electrosense/hardware/converter-design-files/Template2.PcbDoc.htm

Reporting Options

# File in Previous Format

Date | : | 9/7/2021
Time | : | 11:13:33 AM
Filename | : | D:\elesensehw\hardware\converter-design-files\Template2.PcbDoc

Version | Warning

This file was generated by an earlier version of the software
