electrosense/hardware/extension_board_v2/Bill of Materials.xlsx

Name | Description | Designator | Quantity | Supplier 1 | Supplier Part Number 1
BAT1704WH6327XTSA1 |  | BAT1 | 1 | Farnell | 2725755
100nF | smd capaciteit, verp.0603, 100nF | C01, C02, C03, C06, C09, C10, C12, C13, C14, C15, C24, C28, C29, C30, C58 | 15 | Farnell | 2320813
10pF | smd capaciteit, verp.0603, 10pF | C04, C05, C66, C68 | 4 | Farnell | 1414601
10uF | smd capaciteit, tantalium, verp.1206, 10uF/10V | C07, C08 | 2 | Farnell | 2776894
10nF | smd capaciteit, verp.0603, 10nF | C11, C57, C61, C62, C63 | 5 | Farnell | 1907314
10nF | smd capaciteit, verp.0402, 10nF | C16, C17, C18, C19, C40 | 5 | Farnell | 1828887
1uF | smd capaciteit, verp.0603, 1uF | C20, C21, C22, C47 | 4 | Farnell | 1650837
12nF | smd capaciteit, verp.0603, 12nF | C23 | 1 | Farnell | 1865466
820pF | smd capaciteit, verp.0603, 820pF | C25 | 1 | Farnell | 2496915
22pF | smd capaciteit, verp.0402, 22pF | C26, C27, C31, C35, C36, C37 | 6 | Farnell | 2218849
1pF | smd capaciteit, verp.0402, 1pF | C32 | 1 | Farnell | 2781427
CSMD402/1nF | smd capaciteit, verp.0402, 1nF | C33 | 1 | Farnell | 1535558
100nF | smd capaciteit, verp.0402, 100nF | C34, C38, C41, C43, C44, C51, C70 | 6 | Farnell | 2627341
47pF | smd capaciteit, verp.0402, 47pF | C39, C67, C54, C55, C56 | 5 | Farnell | 2332508
100pF | smd capaciteit, verp.0402, 100pF | C42, C53, C45 | 3 | Farnell | 2496792
CSMD402/1.5nF | smd capaciteit, verp.0402, 1.5nF | C46 | 1 | Farnell | 2522382
47pF | smd capaciteit, verp.0603, 47pF | C59, C60, C64, C65 | 4 | Farnell | 1759062
ESD0P8RFL |  | D2, D3, D5 | 3 | Farnell | 1791462
DPX165850DT-8017A1 |  | F1 | 1 | Mouser | 810-DPX16585DT8017A1
CONSMA | SMA connector, rechtop | HIGH, LOW, MID, SDR1 | 4 | Farnell | 1248989
CON SMD USB Micro MOLEX | MOLEX - 47589-0001 - MICRO USB TYPE AB | JUSB | 1 | Digikey | WM17143CT-ND
Ferrite | Ferrite bead, 0805 package | L01, L5 | 2 | Farnell | 1669753
SPL603/51nH |  | L2 | 1 | Farnell | 2286003
SPL805/470nH | smd spoel, verpakking 805, 470nH | L3, L6, L7, L8, L9, L10 | 6 | Farnell | 2286389
HSMG-C190 | led smd groen, Avago Techn., HSMG-C190 | LOCK | 1 | Farnell | 2497374
HSMY-C190 | led smd geel, Avago Techn., HSMY-C190 | MIX | 1 | Farnell | 2497355
1K5 | weerstand SMD603, 1K5 | R01, R05 | 2 | Farnell | 2447592
750 | weerstand SMD603, 750R | R02, R03, R04 | 3 | Farnell | 2447432
51 | weerstand SMD603, 51R | R06, R07, R26, R27, R28 | 5 | Farnell | 2059275
5K1 | weerstand SMD603, 5K1 | R08 | 1 | Farnell | 1670185
270 | weerstand SMD805, 270R | R09 | 2 | Farnell | 1697424
 | weerstandsnetwerk SMD603, 4x 22R | R10 | 1 | Farnell | 2060088
50R/402 | weerstand SMD402, 50R | R12, R13, R14 | 3 | Farnell | 2447183
240 | weerstand SMD603, 240R | R15, R100 | 1 | Farnell | 2447305
 | weerstand SMD603, 30R | R16 | 1 | Farnell | 2141216
91 | weerstand SMD603, 91R | R17 | 1 | Farnell | 2303055
 | weerstand SMD805, 1K8 | R18, R19 | 2 | Farnell | 2447595
20R/402 | weerstand SMD402, 20R | R20 | 1 | Farnell | 2324285
51 | weerstand SMD402, 51R | R21, R22, R23 | 3 | Farnell | 2447183
10K | weerstand SMD603, 10K | R24, R25 | 2 | Farnell | 2447230
390 | weerstand SMD603, 390R | R36HF | 1 | Farnell | 2502455
BR39162B3522U410 | Saw Filter | SAW1 | 1 | Farnell | 2360869
BC856 | PNP transistor, smd | T2HF | 1 | Farnell | 1081242
STM32F103C8T6 |  | U1 | 1 | Farnell | 1447637
IP4220CZ6 | Dual USB 2.0 integrated ESD protection | U2 | 1 | Farnell | 1506629
LD1117-SOT223 |  | U3 | 1 | Farnell | 1467776
MAX2870 |  | U4 | 1 | Farnell | 2517417
MCP9804 | ±0.25°C Typical Accuracy Digital Temperature Sensor | U5 | 1 | Farnell | 1825061
SBB3089Z | RF Amplifier | U6 | 1 | Farnell | 2066354
SKY13286-359LF | SPDT-J2/J1 to RFC | U7 | 1 | Mouser | 873-SKY13286-359LF
LTC5549 |  | U8 | 1 | Farnell | 2506414
ADL5602 | Gain block | U9 | 1 | Farnell | 2377140
SKY13322-375LF |  | U11 | 1 | Mouser | 873-SKY13322-375LF
SA612 |  | U12 | 1 | Farnell | 2212081
HSMH-C190 | led smd rood, Avago Techn., HSMH-C190 | USB | 1 | Mouser | 630-HSMH-C190
KTL/5x3.2mm16MHz | TXC Xtal 16.000 MHz, 5x3.2mm | X1 | 1 | Farnell | 2854044
7L-38.400MDG-T |  | X2 | 1 | Farnell | 2325484
MMSZ4678T1G | Zener diode 1.8V | DZ1 | 1 | Digikey | MMSZ4678T1GOSDKR-ND
