electrosense/hardware/(threads)

Thread 1 (2021-04-15):

could i use this board to connect kiwisdr?

taskx6004, 2021-04-15:
Hi, I need a simple and elegant design to connect kiwisdr, I saw recent update v2 board has deleted only one RF route connected to the up converter mixer, is it capable to mix 60MHz-6Ghz in firmware? Some modification require for RF parts maybe required but I am not sure. I can help with your new board assembly (in Shenzhen).

ingframin, 2021-04-15:
Hello, the circuit is exactly the same in version 2. I simply removed a connector and few components that were not used anymore in later iterations. The redesign is actually a cost reduction rather then a functional redesign. You can for sure use this with the kiwi sdr. As for assembly I am not in a position to change our supplier.

taskx6004, 2021-04-16:
Thanks for the reply, I will try to layout a version without up converter, and look into the firmware.

ingframin, 2021-04-16:
Start from V1 though... The V2 is still work in progress and it doesn't really work yet. Also, if you build V2, mark C30 as DNP or you need to change the firmware to disable MCO and use the TCXO as reference for the PLL.

taskx6004, 2021-04-16:
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
I am porting the design in KiCAD (5.99/6), due to current shortage of ICs, some parts may need to be replaced, I will check my sch and send BOM for availability check. I hope it won't be too hard to put it on a 5x5 cm with 0.4/0.2 via 4 layer board.

If it's appropriate I hope continue using this issue for further questions and hope you can help me figure it out.

taskx6004, 2021-04-19:
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

Hi, I spend some time to re-layout the v1 design by using KiCAD. And here are some concerns about my layout:

- the TCXO output to MCU and the LO Line to up converter part will inevitably cross, i have to use a via jump to feed the XO clock to MCU.
- currently the MCU is more than 10USB, would it be feasible to do it on a STM32g431 or newer more available chips?
- the trace is 50 ohm controlled. but the clock branching and tracing is cornered. I don't know how this board will perform.
Any advice for me? Thank you in advance.

BertoldVdb, 2021-04-19:
You do not need to connect the TCXO to the MCU. This connection is only to use the MCU clock for the PLL REF during testing. If you use one of the newer MCU you can even use the internal oscillator as the accurate clock is only used for USB.

I think it should be quite easy to use another MCU. I find STM32 in general difficult to find at the moment.

The upconverter does not perform well, it was only added to meet a specification requirement.

Closed 2021-04-15.

Thread 2 (2021-07-19):

Can it be use on a LimeSDR (which is limited to 3.8GHz)?

OhSoGood, 2021-07-19:
Hi,
Congratulation for the project, and it's so nice to share it with everybody.

I offered myself a nice LimeSDR a few months ago (it goes up to 3.8GHz), and I was wondering if I could use your board for both RX and TX up to 6GHz? If so, with V1 or V2 of the board?

Are there any drawback you know to use such a converter? RF bandwidth limitation, I/Q balance, interference/harmonics, whatsoever ?

Thanks again

BertoldVdb, 2021-07-19:
Hi,

Yes, it will work with a LimeSDR or any other receiver that can use the
1.575GHz IF. The bandwidth with the filter mentioned in the BOM is quite
low, as it was made for the rtl-sdr. You can replace it with another GPS
SAW with a wider passband.

Sincerely,
Bertold

Op ma 19 jul. 2021 18:27 schreef OhSoGood ***@***.***>:

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

Thread 3 (2022-03-14):

Questions on your design

OhSoGood, 2022-03-14:
Hi,
The overall design of the board is great but there are a few points I don't get:

1. Why to "gather" the input from the 2.4 and 5.8GHz antennas with a RF switch, then to amplify them and next to split them with a diplexer to finally arrive to the SKY13286 RF switch ? Why not a distinct circuit for both bands, each with its own amplifier, and directly connected to the SKY13286 RF switch?
2. Why the ADL5602 amplifier at the final stage? Does the whole chain weaken the signal enough so that we need a LNA/PA at the end? And why not a stronger ampli than SBB3089Z instead of two amplis, one at the head the other at the end of the board?
3. In practice, how many dB does a 2.4 or 5.8 GHz signal loose going through the board?

Thank you very much for the feedback :)
