electrosense/hardware/converter-design-files/schematic.pdf

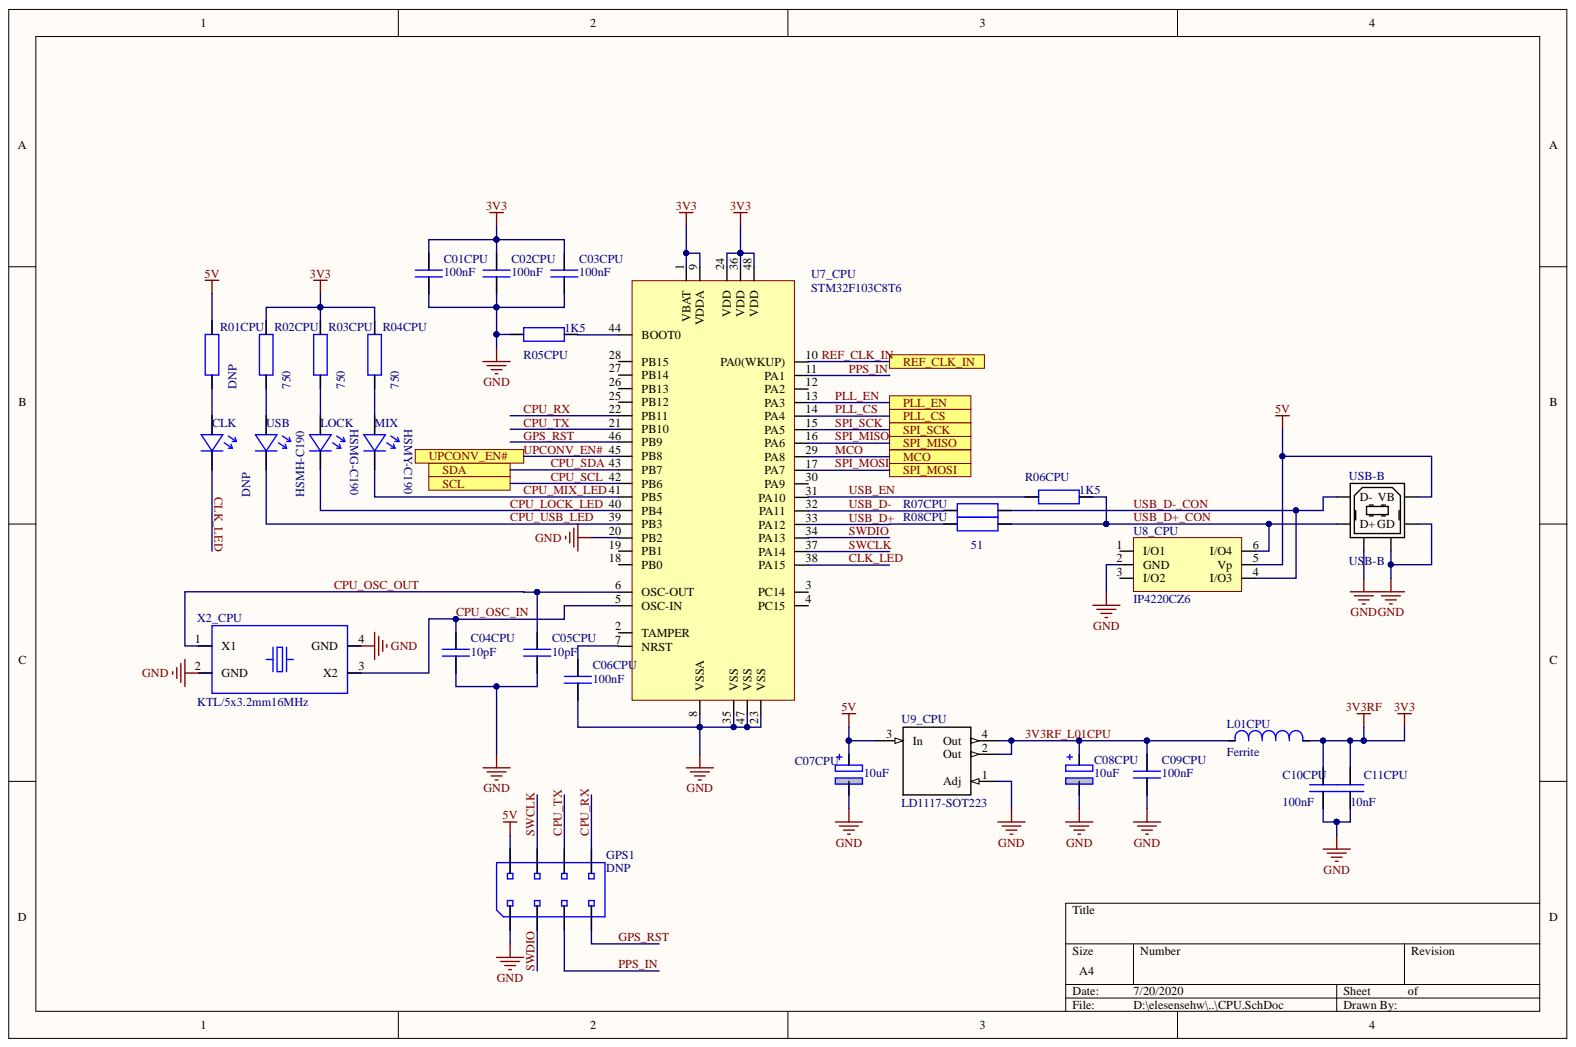
[picture p8: page 1]

PB8 45 PB9 46 | MCO | SPI_MISO

X1 1 | GND

Date: 7/20/2020 | Sheet of
File: D:\elesensehw\..\CPU.SchDoc | Drawn By:

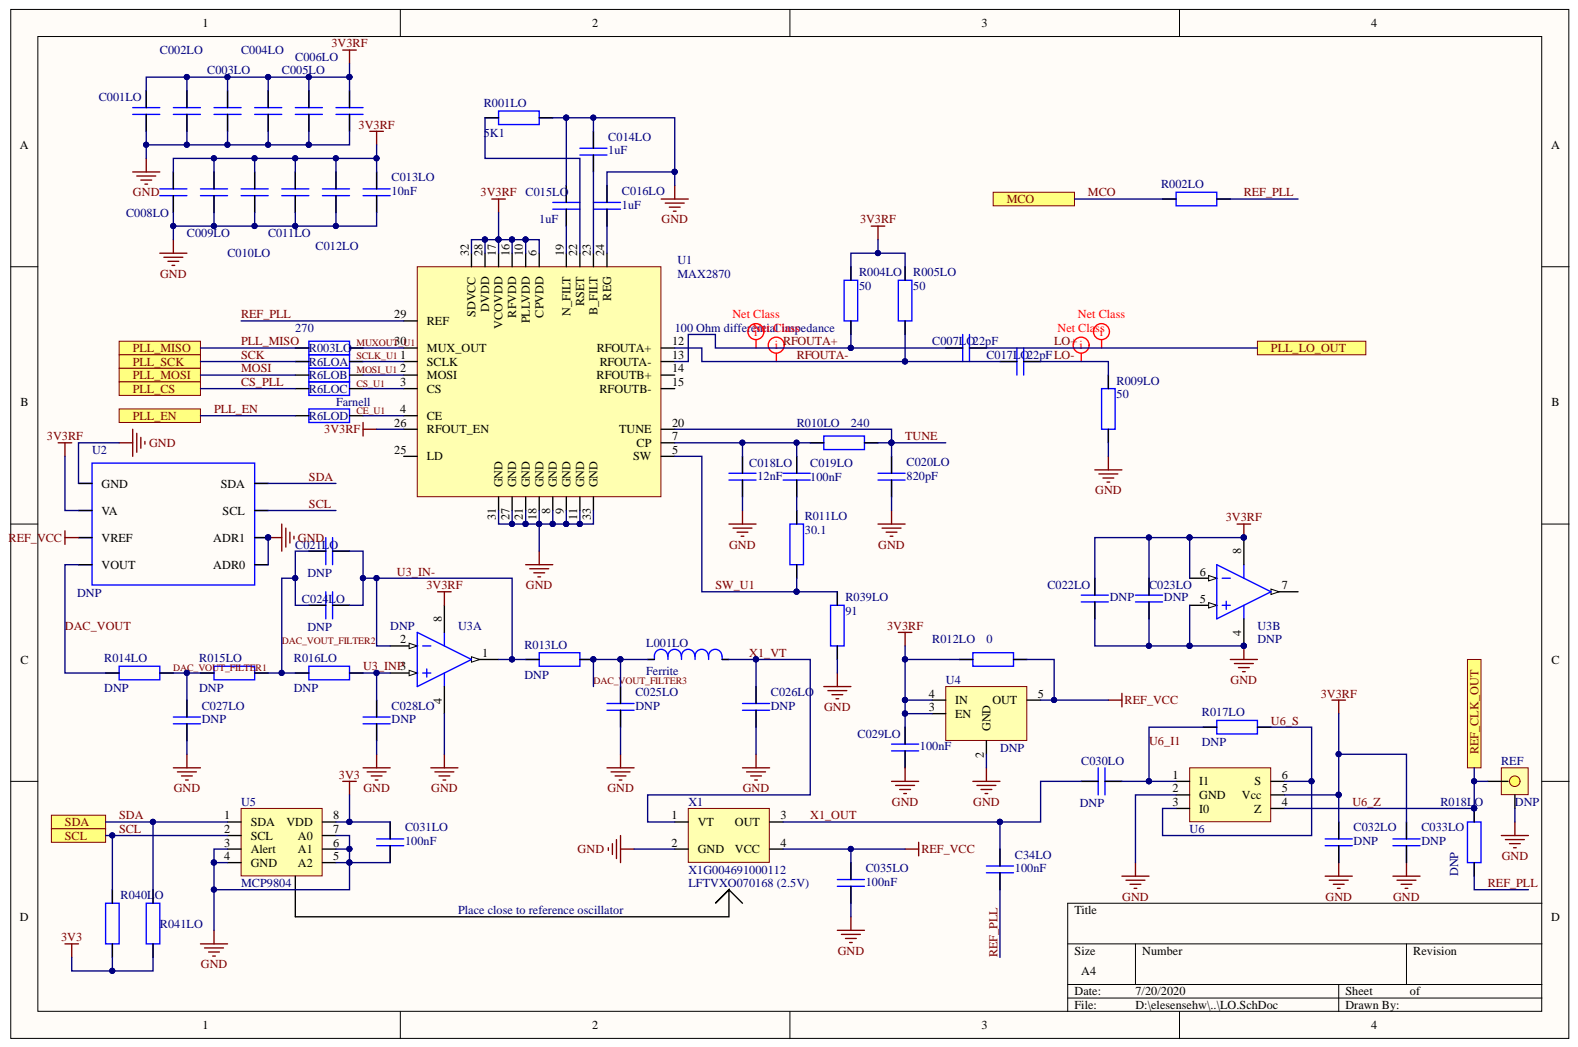
[picture p9: page 2]

SCK | SCLK_U1 | SCLK 1 | RFOUTA- | LO-
MOSI | MOSI_U1 | MOSI 2
CS_PLL | CS_U1 | CS 3

PLL_SCK | R6LOA

PLL_CS | R6LOC

Place close to reference oscillator

Size A4 | Number | Revision

Date: 7/20/2020 | Sheet of
File: D:\elesensehw\..\LO.SchDoc | Drawn By:

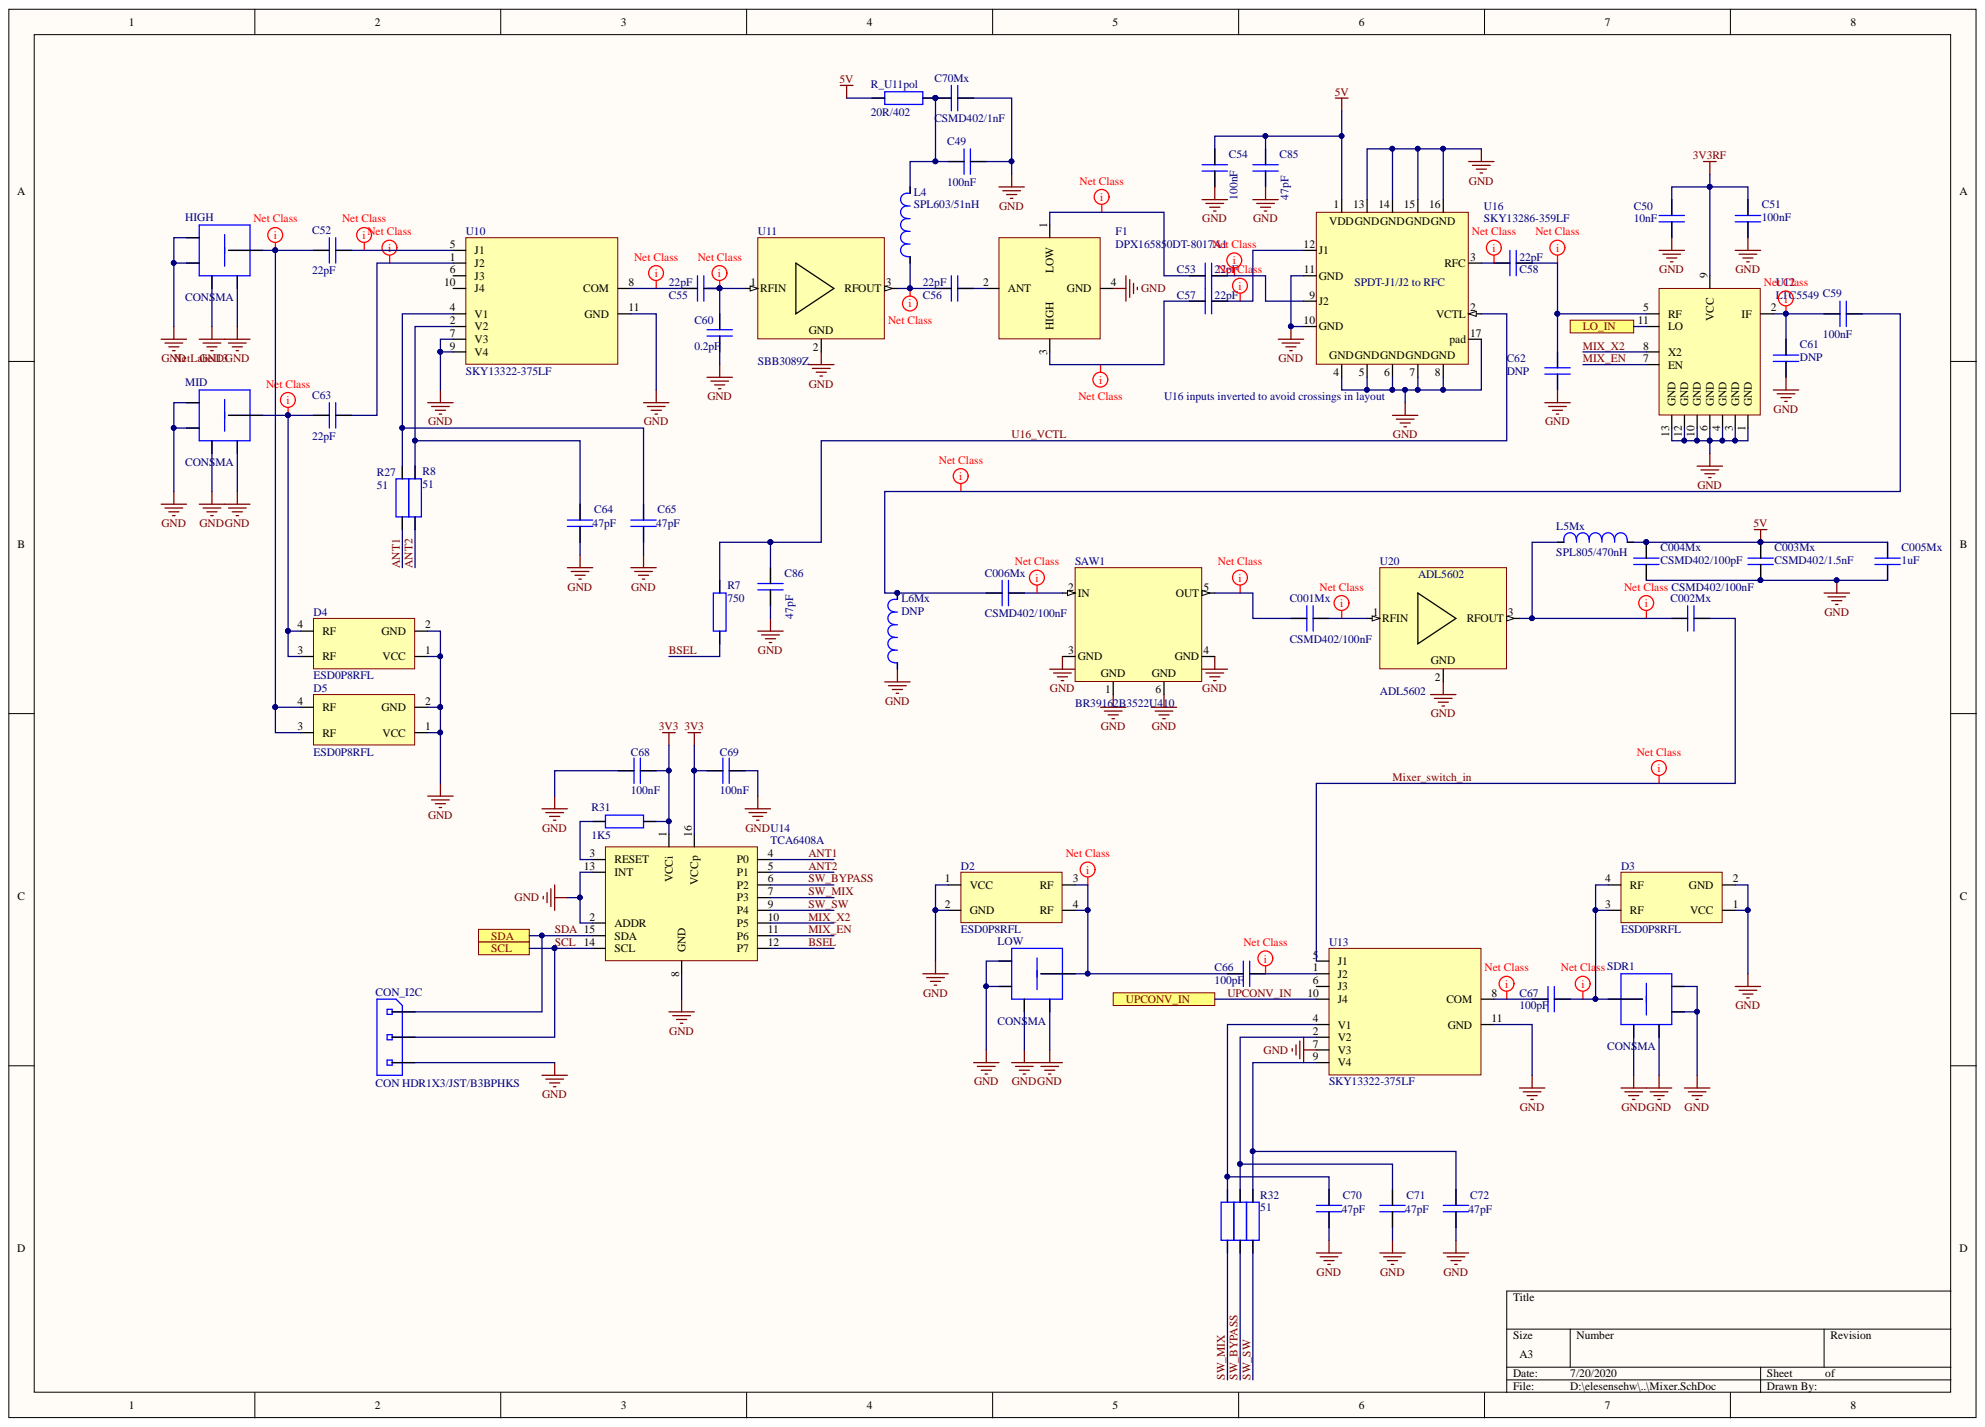
[picture p10: page 3]

U16 inputs inverted to avoid crossings in layout

GND 1 GND 3 GND 4 GND 6 GND 10 GND 12

SDA | SCL | SCL 14
SCL

J2 1 J1 5 | Net Class | SDR1

V3 7
V4 9

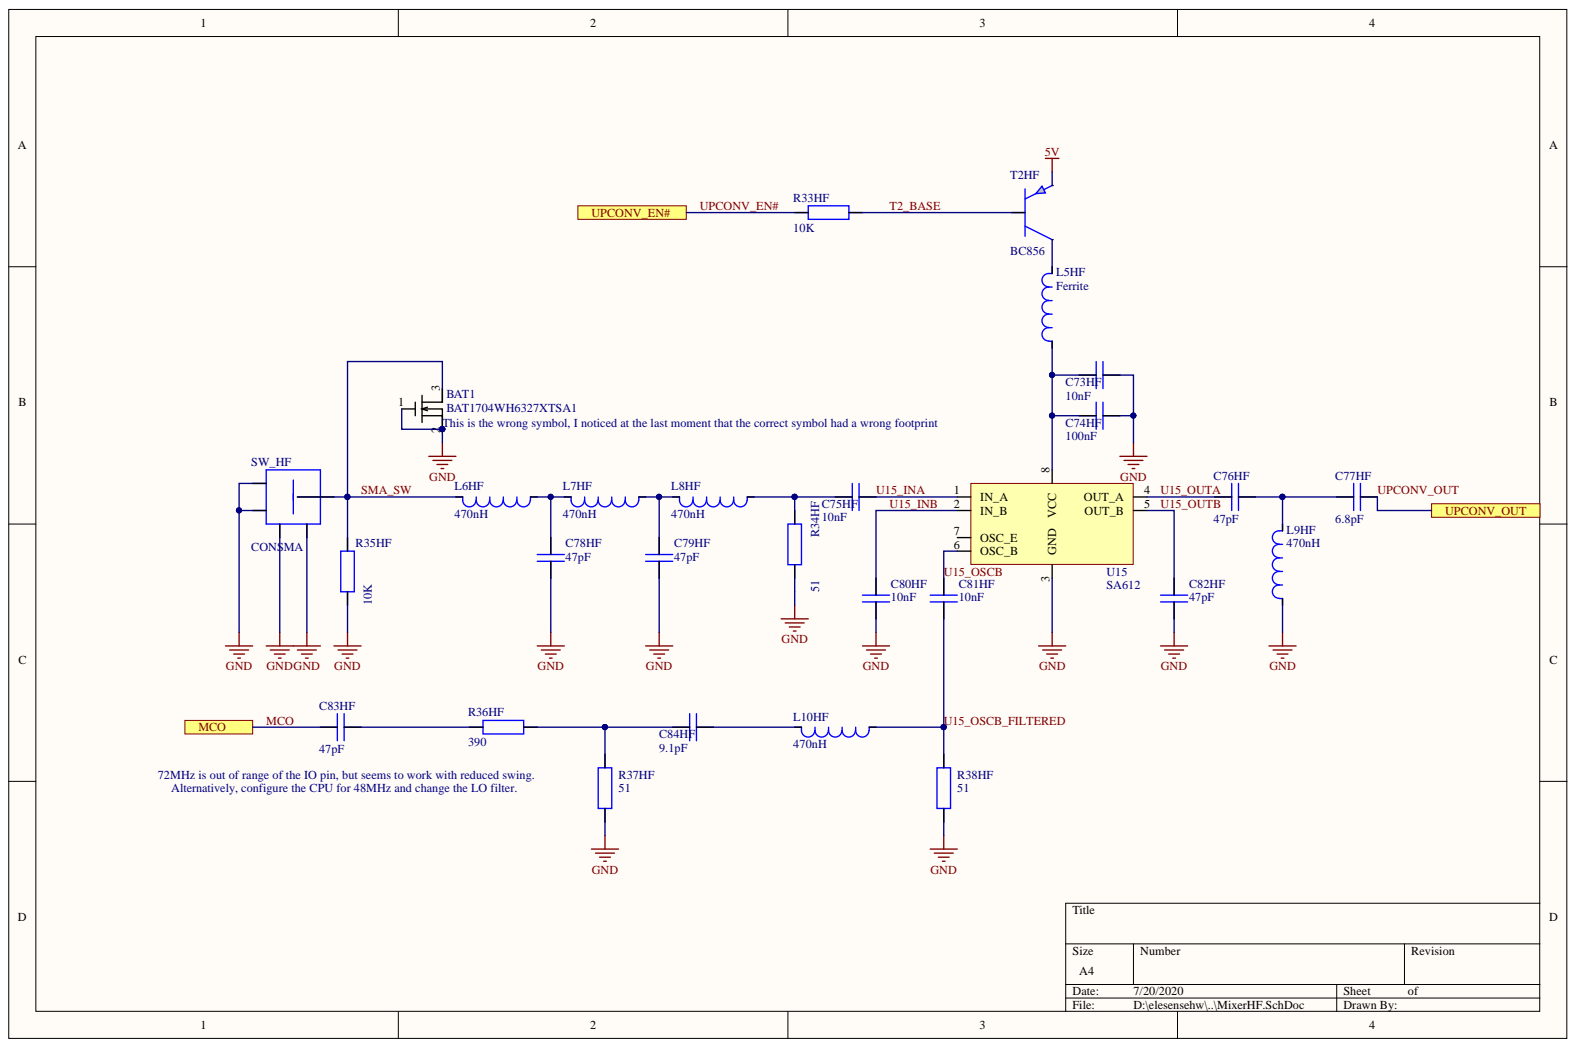
[picture p11: page 4]

3 2 BAT1
BAT1704WH6327XTSA1
This is the wrong symbol, I noticed at the last moment that the correct symbol had a wrong footprint

72MHz is out of range of the IO pin, but seems to work with reduced swing.
Alternatively, configure the CPU for 48MHz and change the LO filter.

Size A4 | Number | Revision

Date: 7/20/2020 | Sheet of
File: D:\elesensehw\..\MixerHF.SchDoc | Drawn By:

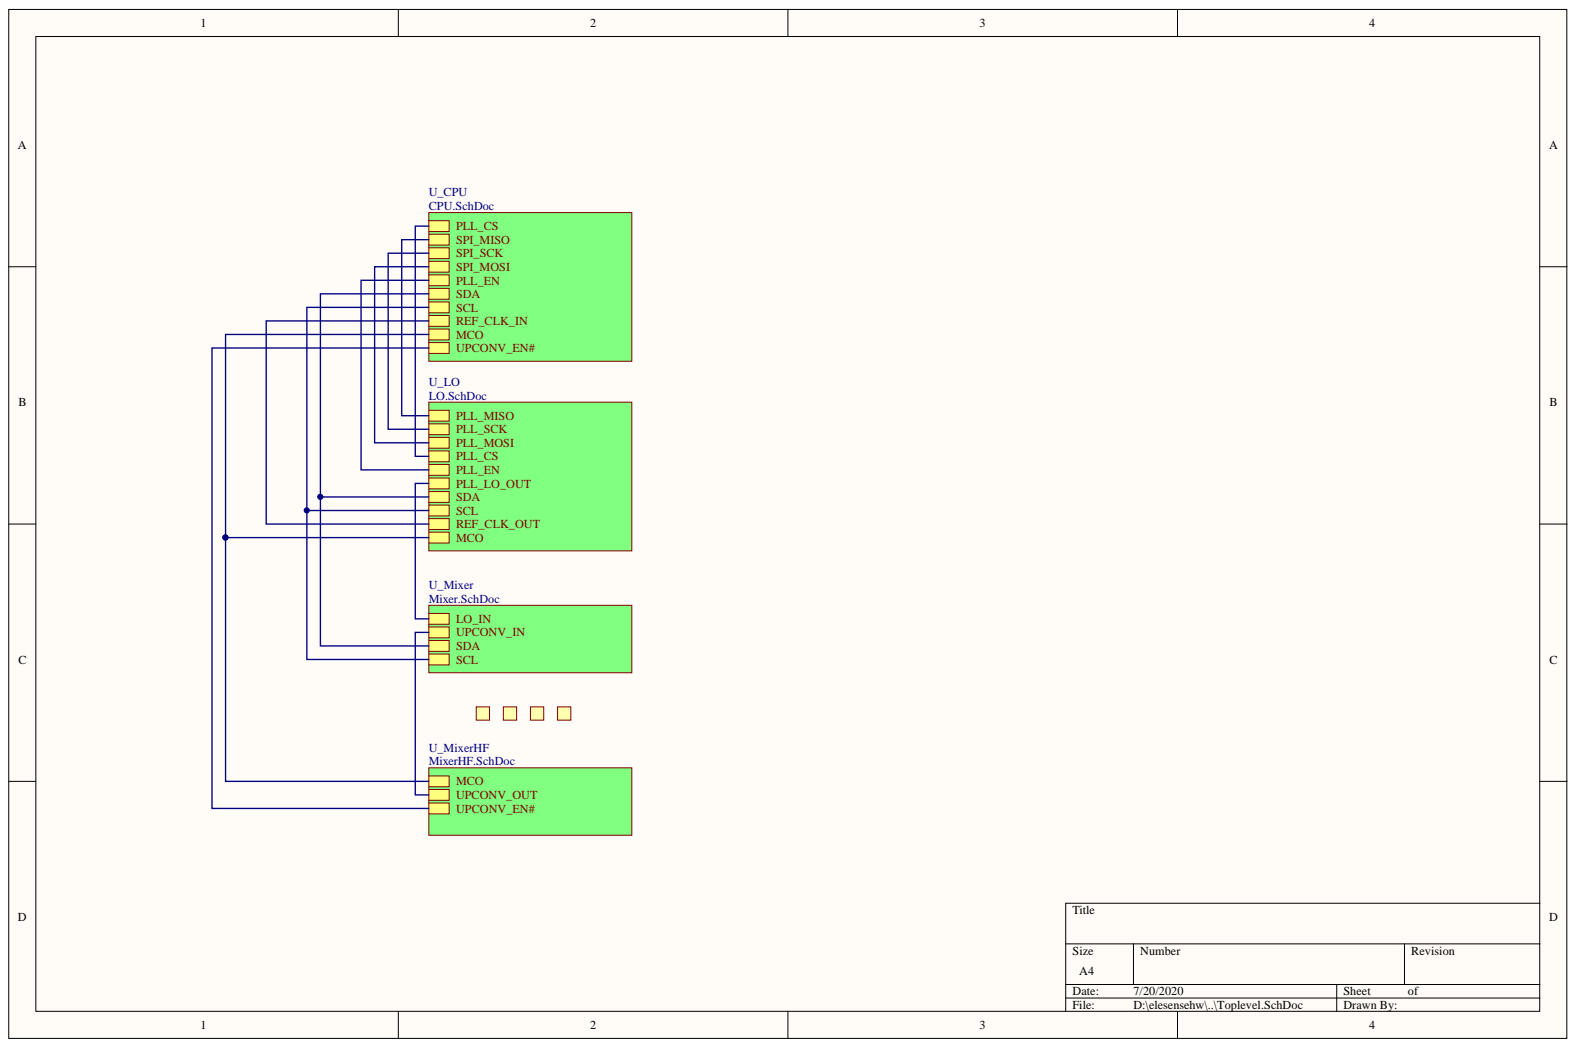
[picture p12: page 5]

Size A4 | Number | Revision

Date: 7/20/2020 | Sheet of
File: D:\elesensehw\..\Toplevel.SchDoc | Drawn By:
