electrosense/hardware/extension_board_v2/PCB_Project3.pdf

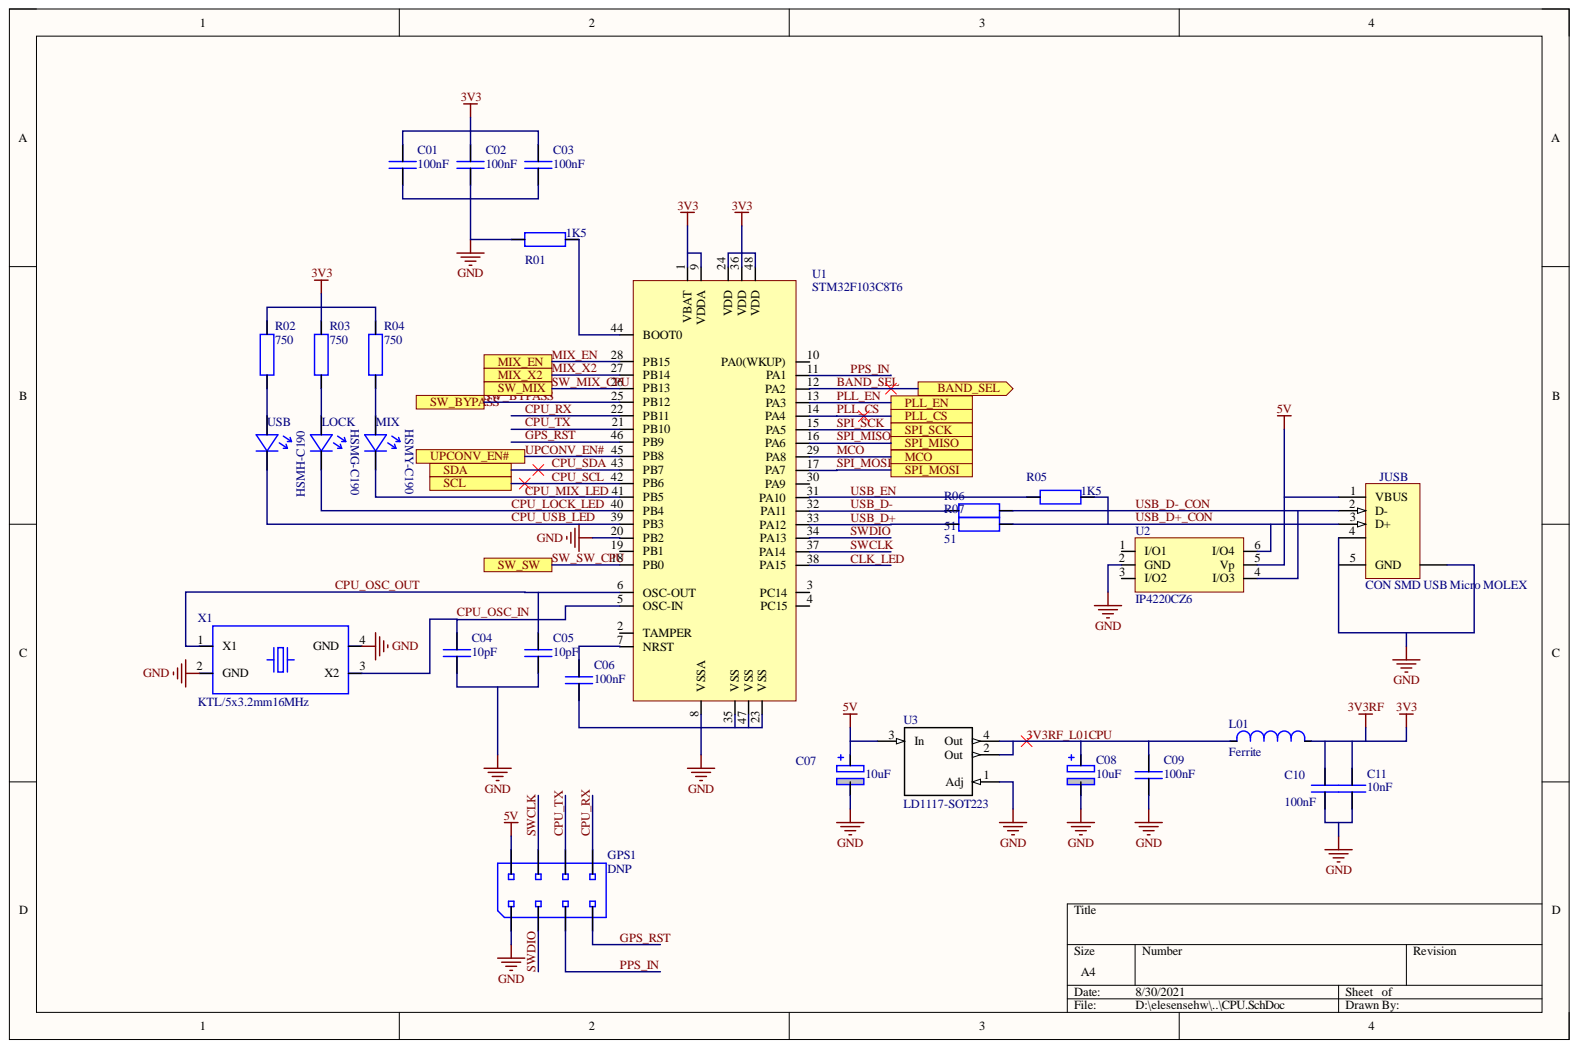
[picture p13: page 1]

CPU_SCL | PB3 39 PB4 40 PB5 41 PB6 42 PB7 43

SDA | SPI_MOSI

CON SMD USB Micro MOLEX

Date: 8/30/2021 | Sheet of
File: D:\elesensehw\..\CPU.SchDoc | Drawn By:

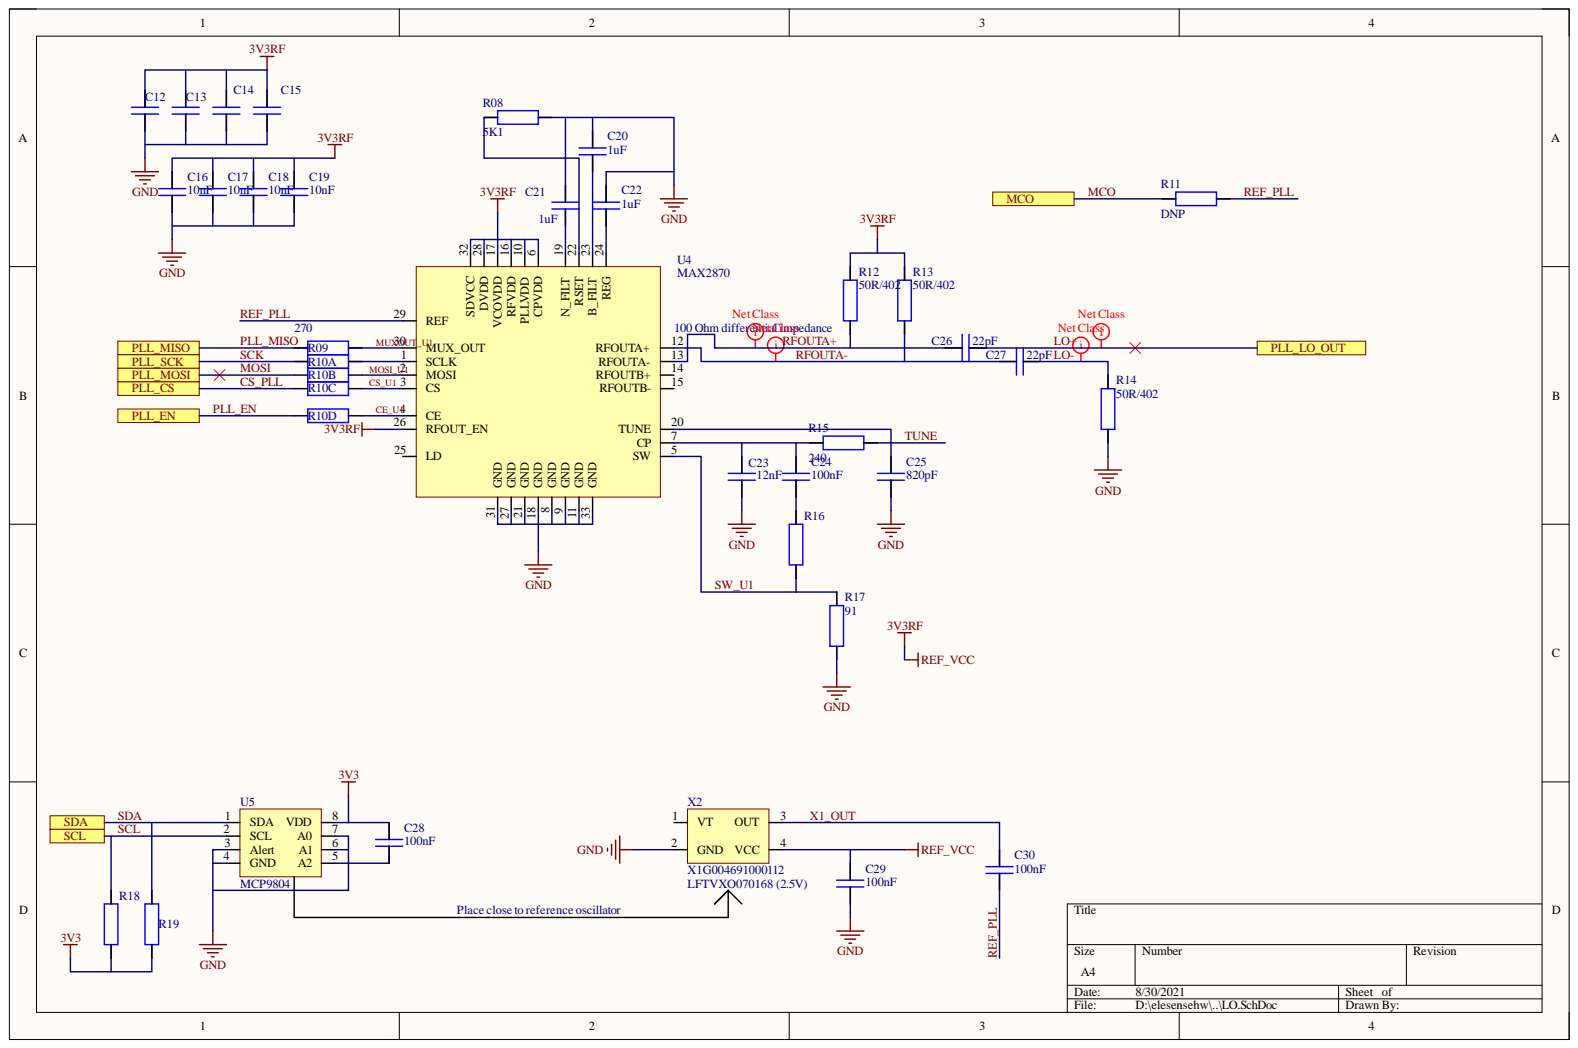
[picture p14: page 2]

SCK | | SCLK 1
MOSI | MOSI_U1 | MOSI 2
CS_PLL | CS_U1 | CS 3

PLL_SCK | R10A
PLL_MOSI | R10B
PLL_CS | R10C

Place close to reference oscillator

Size A4 | Number | Revision

Date: 8/30/2021 | Sheet of
File: D:\elesensehw\..\LO.SchDoc | Drawn By:

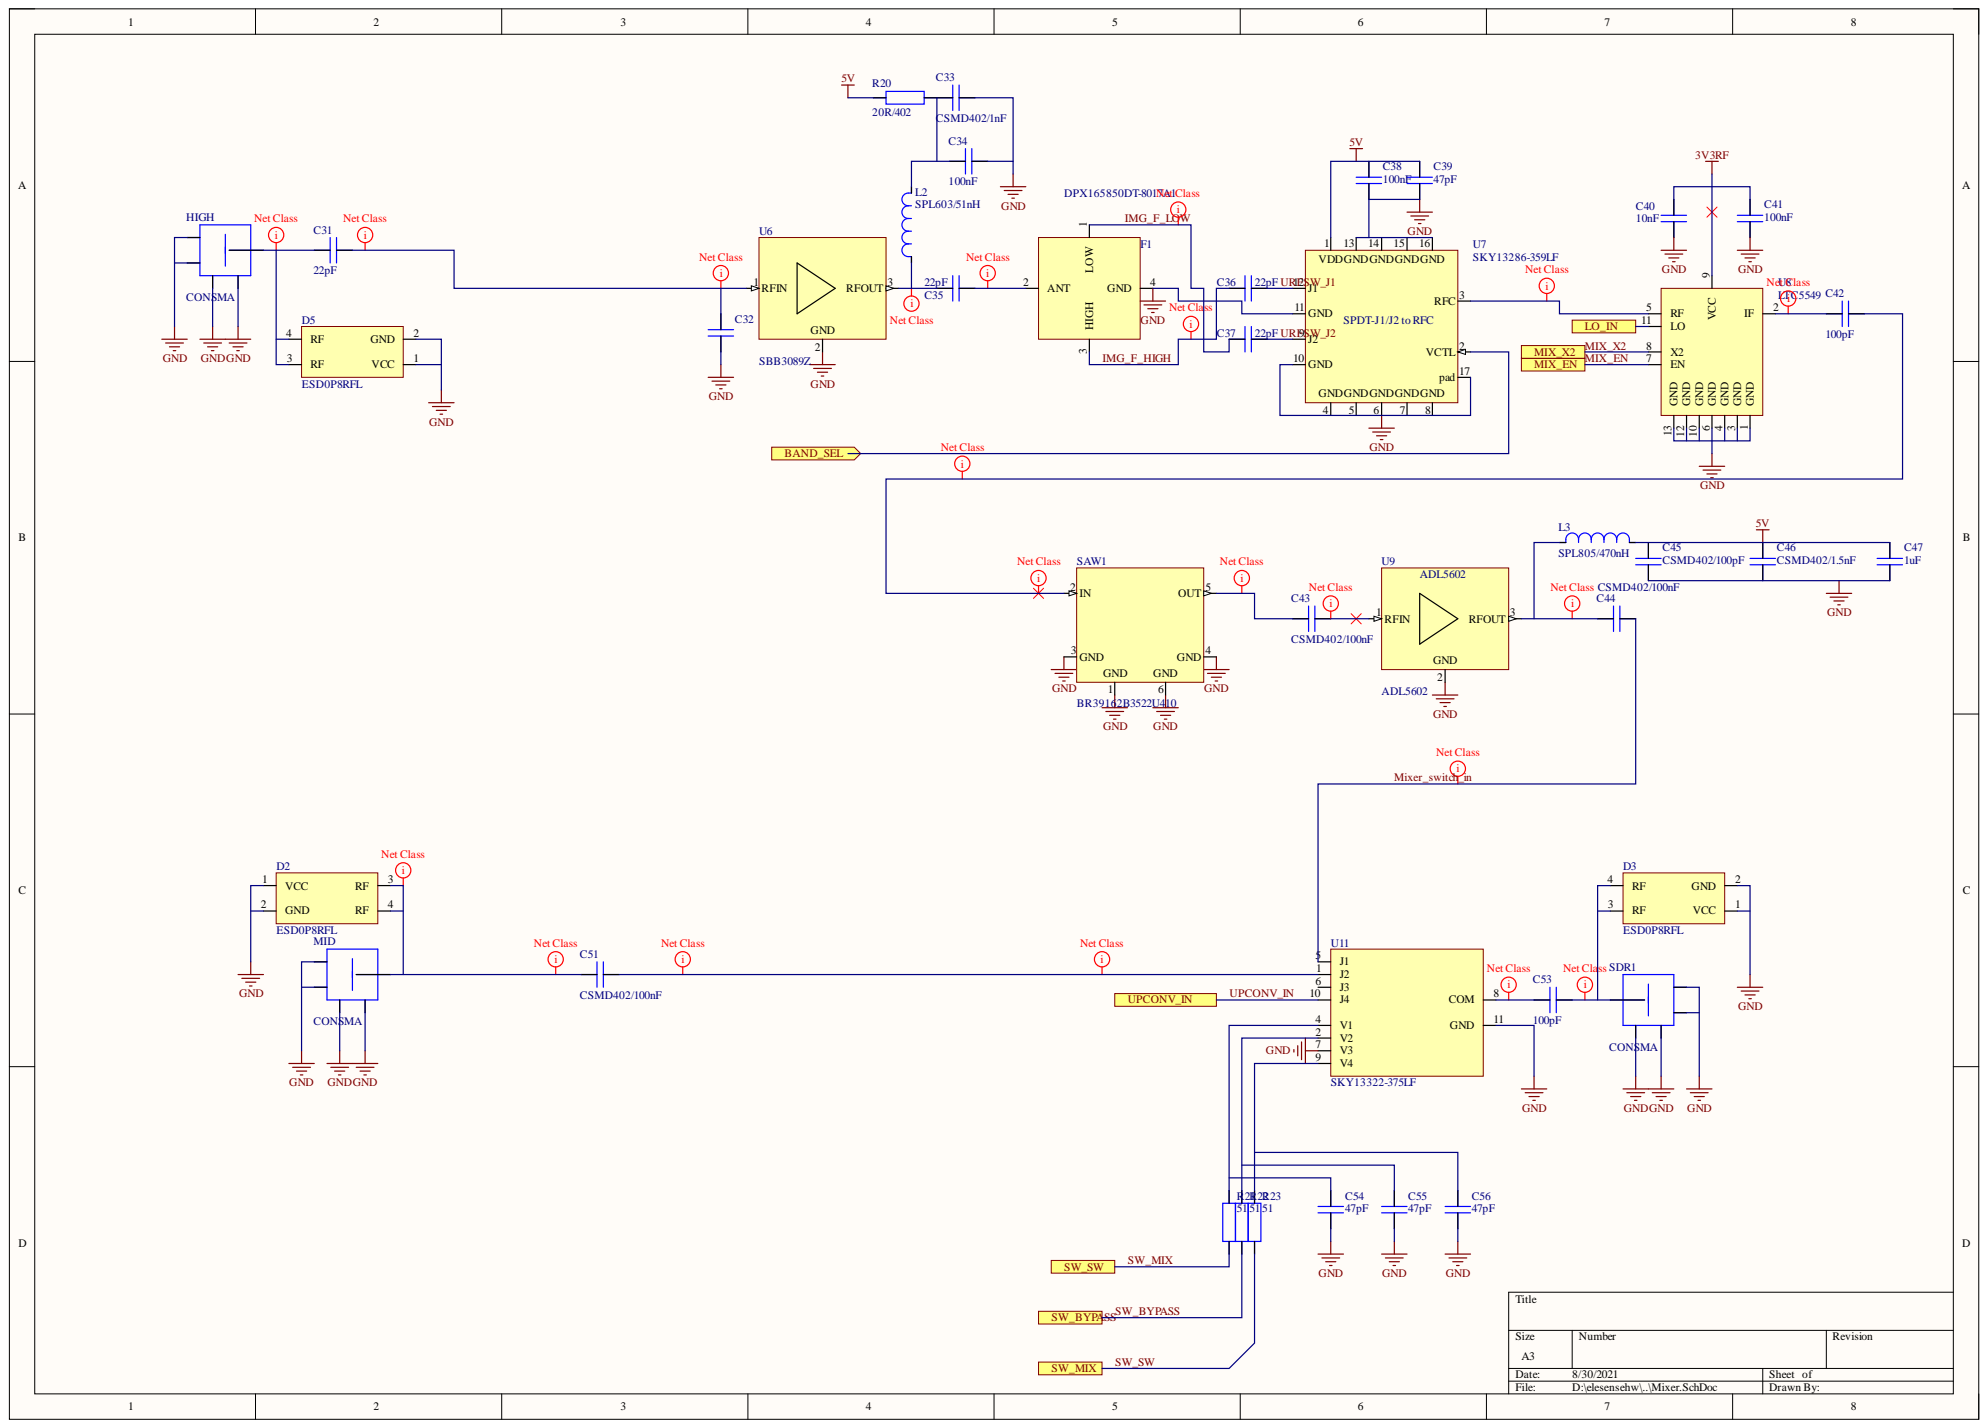
[picture p15: page 3]

GND 1 GND 3 GND 4 GND 6 GND 10 GND 12

R21 | R22
51 | 51

SW_SW | | SW_BYPASS

SW_MIX

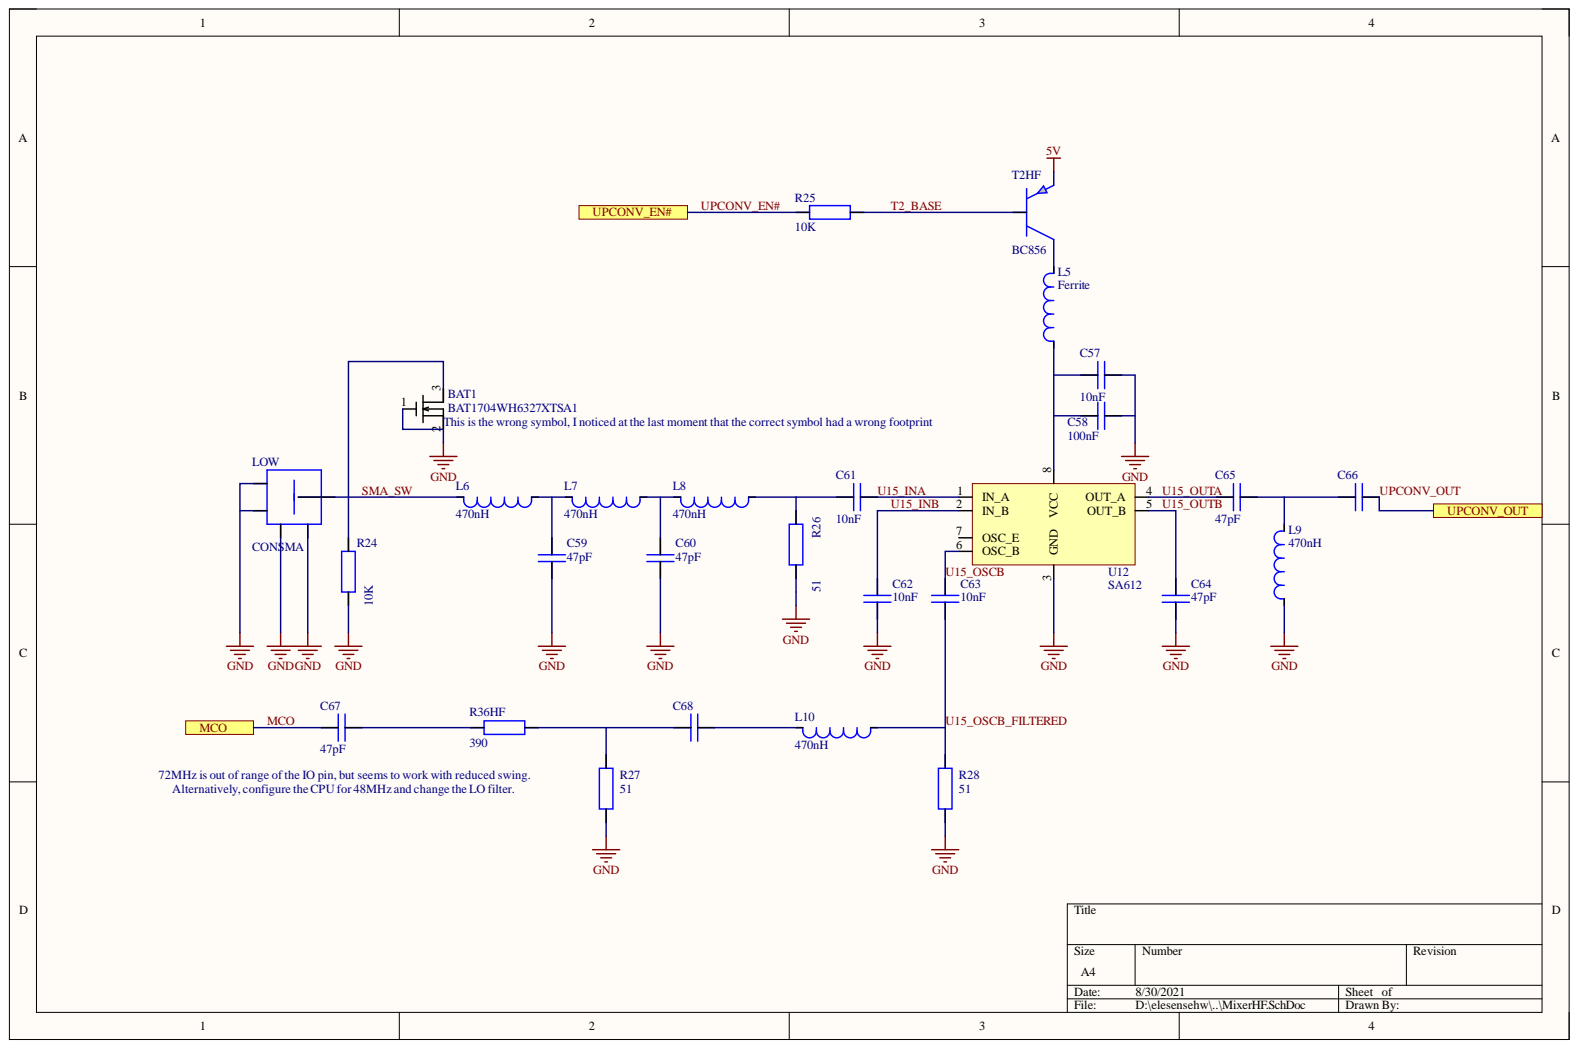
[picture p16: page 4]

BAT1704WH6327XTSA1
This is the wrong symbol, I noticed at the last moment that the correct symbol had a wrong footprint

72MHz is out of range of the IO pin, but seems to work with reduced swing.
Alternatively, configure theCPU for 48MHz and change the LO filter.

Size A4 | Number | Revision

Date: 8/30/2021 | Sheet of
File: D:\elesensehw\..\MixerHF.SchDoc | Drawn By:

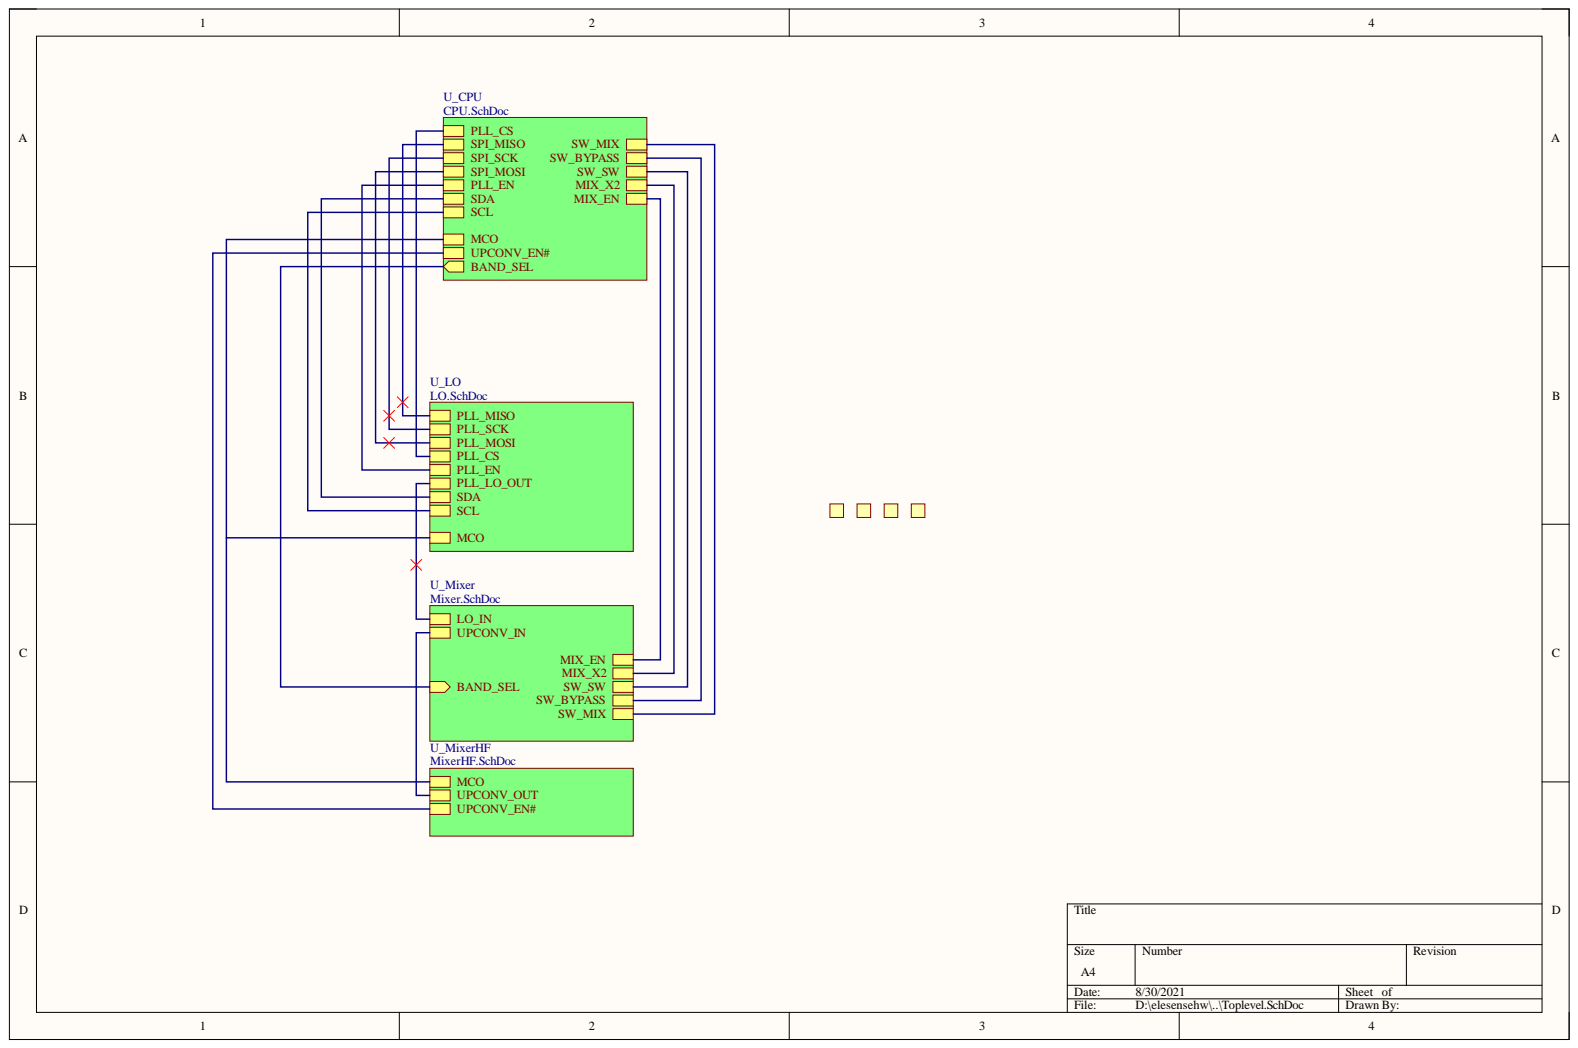
[picture p17: page 5]

Size A4 | Number | Revision

Date: 8/30/2021 | Sheet of
File: D:\elesensehw\..\Toplevel.SchDoc | Drawn By:
