electrosense/hardware/electrosense_hardware.pdf

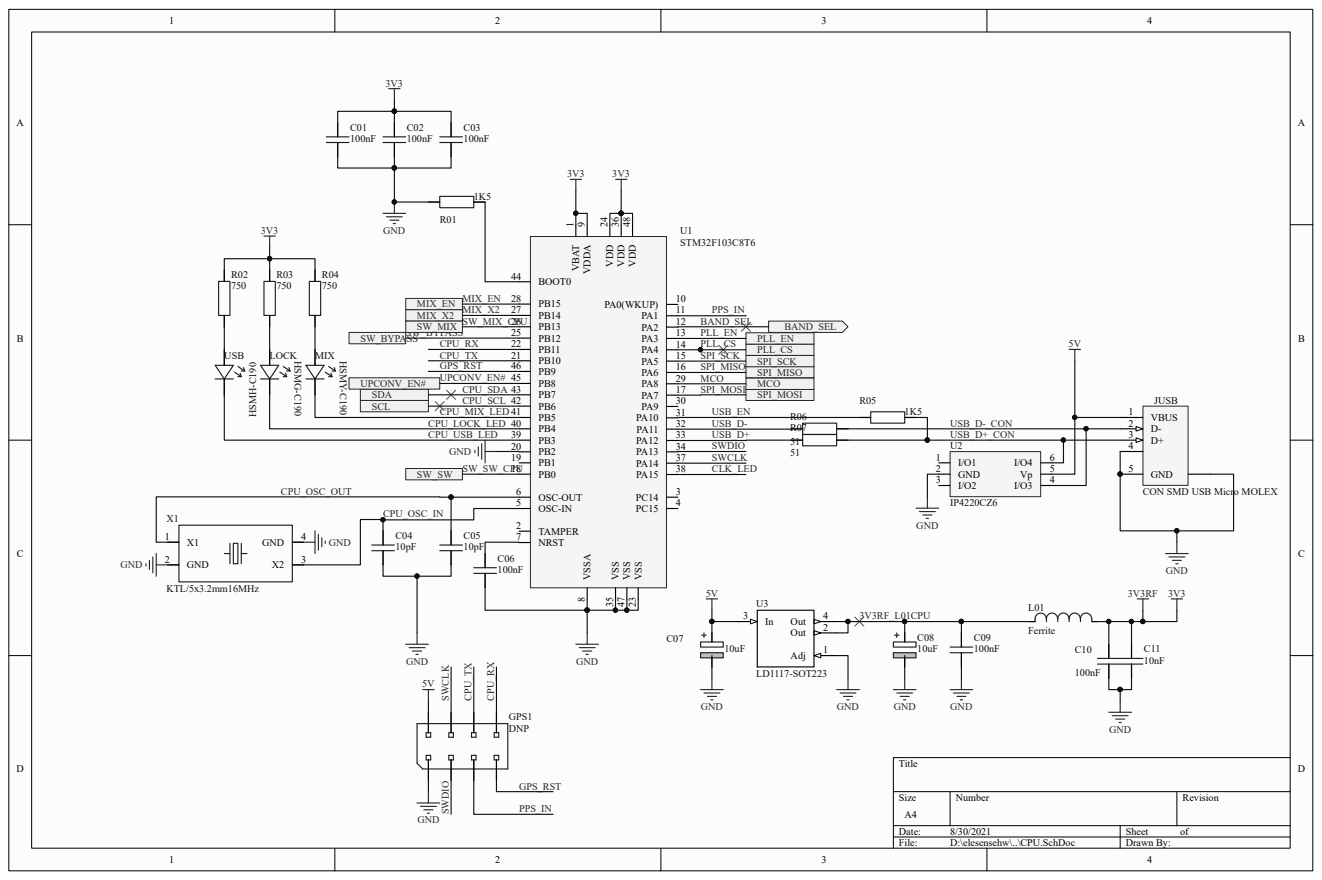
[picture p18: page 1]

CON SMD USB Micro MOLEX
