electrosense/hardware/(list of files, drawings)

Other design files:
converter-design-files/LO.SchDoc
converter-design-files/Mixer.SchDoc
converter-design-files/PCB_Project3.PrjPCB
converter-design-files/Template2.PcbDoc
extension_board_v2/CPU.SchDoc
extension_board_v2/layout.PcbDoc
extension_board_v2/LO.SchDoc
extension_board_v2/Mixer.SchDoc
extension_board_v2/MixerHF.SchDoc
extension_board_v2/PCB_Project3.PrjPCB
extension_board_v2/RF_Comp.PcbLib
extension_board_v2/RF_LIB.SchLib
extension_board_v2/Toplevel.SchDoc
