electrosense/hardware/electrosense-converter-firmware/ChibiOS/os/hal/ports/SPC5/SPC5xx/FlexPWM_v1/hal_pwm_lld.c

/*
    SPC5 HAL - Copyright (C) 2013 STMicroelectronics

    Licensed under the Apache License, Version 2.0 (the "License");
    you may not use this file except in compliance with the License.
    You may obtain a copy of the License at

        http://www.apache.org/licenses/LICENSE-2.0

    Unless required by applicable law or agreed to in writing, software
    distributed under the License is distributed on an "AS IS" BASIS,
    WITHOUT WARRANTIES OR CONDITIONS OF ANY KIND, either express or implied.
    See the License for the specific language governing permissions and
    limitations under the License.
*/

/**
 * @file    FlexPWM_v1/hal_pwm_lld.c
 * @brief   SPC5xx low level PWM driver code.
 *
 * @addtogroup PWM
 * @{
 */

#include "hal.h"

#if HAL_USE_PWM || defined(__DOXYGEN__)

/*===========================================================================*/
/* Driver exported variables.                                                */
/*===========================================================================*/

/**
 * @brief   PWMD1 driver identifier.
 * @note    The driver PWMD1 allocates the complex timer TIM1 when enabled.
 */
#if SPC5_PWM_USE_SMOD0 || defined(__DOXYGEN__)
PWMDriver PWMD1;
#endif

/**
 * @brief   PWMD2 driver identifier.
 * @note    The driver PWMD2 allocates the timer TIM2 when enabled.
 */
#if (SPC5_PWM_USE_SMOD1 && !(SPC5_PWM0_USE_SYNC_SMOD)) || defined(__DOXYGEN__)
PWMDriver PWMD2;
#endif

/**
 * @brief   PWMD3 driver identifier.
 * @note    The driver PWMD3 allocates the timer TIM3 when enabled.
 */
#if (SPC5_PWM_USE_SMOD2 && !(SPC5_PWM0_USE_SYNC_SMOD)) || defined(__DOXYGEN__)
PWMDriver PWMD3;
#endif

/**
 * @brief   PWMD4 driver identifier.
 * @note    The driver PWMD4 allocates the timer TIM4 when enabled.
 */
#if (SPC5_PWM_USE_SMOD3 && !(SPC5_PWM0_USE_SYNC_SMOD)) || defined(__DOXYGEN__)
PWMDriver PWMD4;
#endif

/**
 * @brief   PWMD5 driver identifier.
 * @note    The driver PWMD5 allocates the timer TIM5 when enabled.
 */
#if SPC5_PWM_USE_SMOD4 || defined(__DOXYGEN__)
PWMDriver PWMD5;
#endif

/**
 * @brief   PWMD6 driver identifier.
 * @note    The driver PWMD6 allocates the timer TIM6 when enabled.
 */
#if (SPC5_PWM_USE_SMOD5 && !(SPC5_PWM1_USE_SYNC_SMOD)) || defined(__DOXYGEN__)
PWMDriver PWMD6;
#endif

/**
 * @brief   PWMD7 driver identifier.
 * @note    The driver PWMD7 allocates the timer TIM7 when enabled.
 */
#if (SPC5_PWM_USE_SMOD6 && !(SPC5_PWM1_USE_SYNC_SMOD)) || defined(__DOXYGEN__)
PWMDriver PWMD7;
#endif

/**
 * @brief   PWMD8 driver identifier.
 * @note    The driver PWMD8 allocates the timer TIM8 when enabled.
 */
#if (SPC5_PWM_USE_SMOD7 && !(SPC5_PWM1_USE_SYNC_SMOD)) || defined(__DOXYGEN__)
PWMDriver PWMD8;
#endif

/*===========================================================================*/
/* Driver local variables.                                                   */
/*===========================================================================*/

/**
 * @brief   Number of active FlexPWM0 submodules.
 * @note    When SPC5_PWM0_USE_SYNC_SMOD is TRUE if the FlexPWM0 submodules are
 *          active, flexpwm_active_submodules0 = 1.
 */
static uint32_t flexpwm_active_submodules0;

/**
 * @brief   Number of active FlexPWM1 submodules.
 * @note    When SPC5_PWM1_USE_SYNC_SMOD is TRUE if the FlexPWM1 submodules are
 *          active, flexpwm_active_submodules1 = 1.
 */
static uint32_t flexpwm_active_submodules1;

/*===========================================================================*/
/* Driver local functions.                                                   */
/*===========================================================================*/

/**
 * @brief   Configures and activates the PWM peripheral submodule.
 *
 * @param[in] pwmp      pointer to a @p PWMDriver object
 * @param[in] sid       PWM submodule identifier
 *
 * @notapi
 */
void pwm_lld_start_submodule(PWMDriver *pwmp, uint8_t sid) {
  pwmcnt_t pwmperiod;
  uint32_t psc;
  uint8_t cha;
  uint8_t chb;

/* Retrieve the channel a/b of the submodule sid when the channel 
   synchronization is enabled.*/
#if !(SPC5_PWM0_USE_SYNC_SMOD) && !(SPC5_PWM1_USE_SYNC_SMOD)
  cha = 0;
  chb = 1;
#elif SPC5_PWM0_USE_SYNC_SMOD && !(SPC5_PWM1_USE_SYNC_SMOD)
  if (&PWMD1 == pwmp) {    
    cha = 2 * sid;
    chb = 2 * sid + 1;
  } else  {
    cha = 0;
    chb = 1;
  }
#elif !(SPC5_PWM0_USE_SYNC_SMOD) && SPC5_PWM1_USE_SYNC_SMOD
  if (&PWMD5 == pwmp) {
    cha = 2 * sid;
    chb = 2 * sid + 1;
  } else  {
    cha = 0;
    chb = 1;
  }
#else
  cha = 2 * sid;
  chb = 2 * sid + 1;
#endif

  /* Clears Status Register.*/
  pwmp->flexpwmp->SUB[sid].STS.R = 0xFFFF;

  /* Clears LDOK and initializes the registers.*/
  pwmp->flexpwmp->MCTRL.B.CLDOK |= 1U << sid;

  /* Setting PWM clock frequency and submodule prescaler.*/
  psc = SPC5_FLEXPWM0_CLK / pwmp->config->frequency;

  osalDbgAssert((psc <= 0xFFFF) &&
                (((psc) * pwmp->config->frequency) == SPC5_FLEXPWM0_CLK) &&
                ((psc == 1) || (psc == 2) || (psc == 4) || (psc == 8) ||
                 (psc == 16) || (psc == 32) ||
                 (psc == 64) || (psc == 128)),
                "invalid frequency");

  switch (psc) {
  case 1:
    pwmp->flexpwmp->SUB[sid].CTRL.B.PRSC = SPC5_FLEXPWM_PSC_1;
    break;
  case 2:
    pwmp->flexpwmp->SUB[sid].CTRL.B.PRSC = SPC5_FLEXPWM_PSC_2;
    break;
  case 4:
    pwmp->flexpwmp->SUB[sid].CTRL.B.PRSC = SPC5_FLEXPWM_PSC_4;
    break;
  case 8:
    pwmp->flexpwmp->SUB[sid].CTRL.B.PRSC = SPC5_FLEXPWM_PSC_8;
    break;
  case 16:
    pwmp->flexpwmp->SUB[sid].CTRL.B.PRSC = SPC5_FLEXPWM_PSC_16;
    break;
  case 32:
    pwmp->flexpwmp->SUB[sid].CTRL.B.PRSC = SPC5_FLEXPWM_PSC_32;
    break;
  case 64:
    pwmp->flexpwmp->SUB[sid].CTRL.B.PRSC = SPC5_FLEXPWM_PSC_64;
    break;
  case 128:
    pwmp->flexpwmp->SUB[sid].CTRL.B.PRSC = SPC5_FLEXPWM_PSC_128;
    break;
  }

  /* Disables PWM FAULT function. */
  pwmp->flexpwmp->SUB[sid].DISMAP.R = 0;
  pwmp->flexpwmp->SUB[sid].CTRL2.B.INDEP = 1U;

  /* Sets PWM period.*/
  pwmperiod = pwmp->period;
  pwmp->flexpwmp->SUB[sid].INIT.R = ~(pwmperiod / 2) + 1U;
  pwmp->flexpwmp->SUB[sid].VAL[0].R = 0;
  pwmp->flexpwmp->SUB[sid].VAL[1].R = pwmperiod / 2;

  /* Sets the submodule channels.*/
  switch (pwmp->config->mode & PWM_ALIGN_MASK) {
  case PWM_ALIGN_EDGE:
    /* Setting reloads.*/
    pwmp->flexpwmp->SUB[sid].CTRL.B.HALF = 0;
    pwmp->flexpwmp->SUB[sid].CTRL.B.FULL = 1;

    /* Setting active front of PWM channels.*/
    pwmp->flexpwmp->SUB[sid].VAL[2].R = ~(pwmperiod / 2) + 1U;
    pwmp->flexpwmp->SUB[sid].VAL[4].R = ~(pwmperiod / 2) + 1U;
    break;
  case PWM_ALIGN_CENTER:
    /* Setting reloads.*/
    pwmp->flexpwmp->SUB[sid].CTRL.B.HALF = 1;
    pwmp->flexpwmp->SUB[sid].CTRL.B.FULL = 0;
    break;
  default:
    ;
  }

  /* Polarities setup.*/
  switch (pwmp->config->channels[cha].mode & PWM_OUTPUT_MASK) {
  case PWM_OUTPUT_ACTIVE_LOW:
    pwmp->flexpwmp->SUB[sid].OCTRL.B.POLA = 1;

    /* Enables CHA mask and CHA.*/
    pwmp->flexpwmp->MASK.B.MASKA |= 1U << sid;
    pwmp->flexpwmp->OUTEN.B.PWMA_EN |= 1U << sid;

    break;
  case PWM_OUTPUT_ACTIVE_HIGH:
    pwmp->flexpwmp->SUB[sid].OCTRL.B.POLA = 0;

    /* Enables CHA mask and CHA.*/
    pwmp->flexpwmp->MASK.B.MASKA |= 1U << sid;
    pwmp->flexpwmp->OUTEN.B.PWMA_EN |= 1U << sid;

    break;
  case PWM_OUTPUT_DISABLED:
    /* Enables CHA mask.*/
    pwmp->flexpwmp->MASK.B.MASKA |= 1U << sid;

    break;
  default:
    ;
  }
  switch (pwmp->config->channels[chb].mode & PWM_OUTPUT_MASK) {
  case PWM_OUTPUT_ACTIVE_LOW:
    pwmp->flexpwmp->SUB[sid].OCTRL.B.POLB = 1;

    /* Enables CHB mask and CHB.*/
    pwmp->flexpwmp->MASK.B.MASKB |= 1U << sid;
    pwmp->flexpwmp->OUTEN.B.PWMB_EN |= 1U << sid;

    break;
  case PWM_OUTPUT_ACTIVE_HIGH:
    pwmp->flexpwmp->SUB[sid].OCTRL.B.POLB = 0;

    /* Enables CHB mask and CHB.*/
    pwmp->flexpwmp->MASK.B.MASKB |= 1U << sid;
    pwmp->flexpwmp->OUTEN.B.PWMB_EN |= 1U << sid;

    break;
  case PWM_OUTPUT_DISABLED:
    /* Enables CHB mask.*/
    pwmp->flexpwmp->MASK.B.MASKB |= 1U << sid;

    break;
  default:
    ;
  }

  /* Complementary output setup.*/
  switch (pwmp->config->channels[cha].mode & PWM_COMPLEMENTARY_OUTPUT_MASK) {
  case PWM_COMPLEMENTARY_OUTPUT_ACTIVE_LOW:
    osalDbgAssert(pwmp->config->channels[chb].mode == PWM_OUTPUT_ACTIVE_LOW,
                  "the PWM chB must be set in PWM_OUTPUT_ACTIVE_LOW");
    pwmp->flexpwmp->SUB[sid].OCTRL.B.POLA = 1;
    pwmp->flexpwmp->SUB[sid].CTRL2.B.INDEP = 0;
    pwmp->flexpwmp->OUTEN.B.PWMA_EN |= 1U << sid;
    break;
  case PWM_COMPLEMENTARY_OUTPUT_ACTIVE_HIGH:
    osalDbgAssert(pwmp->config->channels[chb].mode == PWM_OUTPUT_ACTIVE_HIGH,
                  "the PWM chB must be set in PWM_OUTPUT_ACTIVE_HIGH");
    pwmp->flexpwmp->SUB[sid].CTRL2.B.INDEP = 0;
    pwmp->flexpwmp->OUTEN.B.PWMA_EN |= 1U << sid;
    break;
  default:
    ;
  }

  switch (pwmp->config->channels[chb].mode & PWM_COMPLEMENTARY_OUTPUT_MASK) {
  case PWM_COMPLEMENTARY_OUTPUT_ACTIVE_LOW:
    osalDbgAssert(pwmp->config->channels[cha].mode == PWM_OUTPUT_ACTIVE_LOW,
                  "the PWM chA must be set in PWM_OUTPUT_ACTIVE_LOW");
    pwmp->flexpwmp->SUB[sid].CTRL2.B.INDEP = 0;
    pwmp->flexpwmp->MCTRL.B.IPOL &= ~ (1U << sid);
    pwmp->flexpwmp->SUB[sid].OCTRL.B.POLB = 1;
    pwmp->flexpwmp->OUTEN.B.PWMB_EN |= 1U << sid;
    break;
  case PWM_COMPLEMENTARY_OUTPUT_ACTIVE_HIGH:
    osalDbgAssert(pwmp->config->channels[cha].mode == PWM_OUTPUT_ACTIVE_HIGH,
                  "the PWM chA must be set in PWM_OUTPUT_ACTIVE_HIGH");
    pwmp->flexpwmp->SUB[sid].CTRL2.B.INDEP = 0;
    pwmp->flexpwmp->MCTRL.B.IPOL |= 1U << sid;
    pwmp->flexpwmp->OUTEN.B.PWMB_EN |= 1U << sid;
    break;
  default:
    ;
  }

  /* Set to 0 the deadtime when the channels are complementary */
  if (pwmp->flexpwmp->SUB[sid].CTRL2.B.INDEP == 0) {
    pwmp->flexpwmp->SUB[sid].DTCNT0.R = 0x0;
    pwmp->flexpwmp->SUB[sid].DTCNT1.R = 0x0;
  }

  /* Sets the INIT and MASK registers.*/
  pwmp->flexpwmp->SUB[sid].CTRL2.B.FRCEN = 1U;
  pwmp->flexpwmp->SUB[sid].CTRL2.B.FORCE = 1U;

  /* Sets as counter init of submodules 1-3 the master sync from the
     submodule 0.*/
#if SPC5_PWM0_USE_SYNC_SMOD
  if (&PWMD1 == pwmp && sid != 0)
    pwmp->flexpwmp->SUB[sid].CTRL2.B.INIT_SEL = 2U;
#endif
#if SPC5_PWM1_USE_SYNC_SMOD
  if (&PWMD5 == pwmp && sid != 0)
    pwmp->flexpwmp->SUB[sid].CTRL2.B.INIT_SEL = 2U;
#endif

  /* Updates SMOD registers and starts SMOD.*/
  pwmp->flexpwmp->MCTRL.B.LDOK |= 1U << sid;
  pwmp->flexpwmp->MCTRL.B.RUN |= 1U << sid;
}

/**
 * @brief   Enables a PWM channel of a submodule.
 *
 * @param[in] pwmp      pointer to a @p PWMDriver object
 * @param[in] channel   PWM channel identifier (0...PWM_CHANNELS-1)
 * @param[in] width     PWM pulse width as clock pulses number
 * @param[in] sid       PWM submodule id
 *
 * @notapi
 */
void pwm_lld_enable_submodule_channel(PWMDriver *pwmp,
                                  pwmchannel_t channel,
                                  pwmcnt_t width, uint8_t sid) {
  pwmcnt_t pwmperiod;
  int16_t nwidth;
  pwmperiod = pwmp->period;
  nwidth = width - (pwmperiod / 2);

  /* Clears LDOK.*/
  pwmp->flexpwmp->MCTRL.B.CLDOK |= 1U << sid;

  /* Activates the width interrupt.*/
  if ((channel % 2) == 0) {
    if (pwmp->config->channels[channel].callback != NULL) {
      if ((pwmp->flexpwmp->SUB[sid].INTEN.B.CMPIE & 0x08) == 0) {
        pwmp->flexpwmp->SUB[sid].INTEN.B.CMPIE |= 0x08;
      }
    }

    /* Sets the channel width.*/
    switch (pwmp->config->mode & PWM_ALIGN_MASK) {
    case PWM_ALIGN_EDGE:
      if (nwidth >= 0)
        pwmp->flexpwmp->SUB[sid].VAL[3].R = nwidth;
      else
        pwmp->flexpwmp->SUB[sid].VAL[3].R = ~((pwmperiod / 2) - width) + 1U;
      break;
    case PWM_ALIGN_CENTER:
      pwmp->flexpwmp->SUB[sid].VAL[3].R = width / 2;
      pwmp->flexpwmp->SUB[sid].VAL[2].R = ~(width / 2) + 1U;
      break;
    default:
      ;
    }

    /* Removes the channel mask if it is necessary.*/
    if ((pwmp->flexpwmp->MASK.B.MASKA & (1U << sid)) == (1U << sid))
      pwmp->flexpwmp->MASK.B.MASKA &= ~ (1U << sid);

    if ((pwmp->config->channels[channel].mode & PWM_COMPLEMENTARY_OUTPUT_MASK) != 0) {
      pwmp->flexpwmp->MASK.B.MASKB &= ~ (1U << sid);
    }
  }
  /* Activates the width interrupt.*/
  else {
    if (pwmp->config->channels[channel].callback != NULL) {
      if ((pwmp->flexpwmp->SUB[sid].INTEN.B.CMPIE & 0x20) == 0) {
        pwmp->flexpwmp->SUB[sid].INTEN.B.CMPIE |= 0x20;
      }
    }
    /* Sets the channel width.*/
    switch (pwmp->config->mode & PWM_ALIGN_MASK) {
    case PWM_ALIGN_EDGE:
      if (nwidth >= 0)
        pwmp->flexpwmp->SUB[sid].VAL[5].R = nwidth;
      else
        pwmp->flexpwmp->SUB[sid].VAL[5].R = ~((pwmperiod / 2) - width) + 1U;
      break;
    case PWM_ALIGN_CENTER:
      pwmp->flexpwmp->SUB[sid].VAL[5].R = width / 2;
      pwmp->flexpwmp->SUB[sid].VAL[4].R = ~(width / 2) + 1U;
      break;
    default:
      ;
    }

    /* Removes the channel mask if it is necessary.*/
    if ((pwmp->flexpwmp->MASK.B.MASKB & (1U << sid)) == (1U << sid))
      pwmp->flexpwmp->MASK.B.MASKB &= ~ (1U << sid);

    if ((pwmp->config->channels[channel].mode & PWM_COMPLEMENTARY_OUTPUT_MASK) != 0) {
      pwmp->flexpwmp->MASK.B.MASKA &= ~ (1U << sid);
    }
  }

  /* Activates the periodic interrupt. If channel synchronization is enabled,
     only the periodic interrupt of submodule 0 is activeted. */
#if  !(SPC5_PWM0_USE_SYNC_SMOD) && !(SPC5_PWM1_USE_SYNC_SMOD)
  if (pwmp->flexpwmp->SUB[sid].INTEN.B.RIE != 1U) {
    if (pwmp->config->callback != NULL) {
      pwmp->flexpwmp->SUB[sid].INTEN.B.RIE = 1;
    }
  }
#elif SPC5_PWM0_USE_SYNC_SMOD && !(SPC5_PWM1_USE_SYNC_SMOD)
  if (!(&PWMD1 == pwmp && sid != 0)) {
    if (pwmp->flexpwmp->SUB[sid].INTEN.B.RIE != 1U) {
      if (pwmp->config->callback != NULL) {
        pwmp->flexpwmp->SUB[sid].INTEN.B.RIE = 1;
      }
    }
  }
#elif !(SPC5_PWM0_USE_SYNC_SMOD) && SPC5_PWM1_USE_SYNC_SMOD
  if (!(&PWMD5 == pwmp && sid != 0)) {
    if (pwmp->flexpwmp->SUB[sid].INTEN.B.RIE != 1U) {
      if (pwmp->config->callback != NULL) {
        pwmp->flexpwmp->SUB[sid].INTEN.B.RIE = 1;
      }
    }
  }
#else
  if (!((SPC5_PWM0_USE_SYNC_SMOD && &PWMD1 == pwmp && sid != 0) || 
        (SPC5_PWM1_USE_SYNC_SMOD && &PWMD5 == pwmp && sid != 0))) {
    if (pwmp->flexpwmp->SUB[sid].INTEN.B.RIE != 1U) {
      if (pwmp->config->callback != NULL) {
        pwmp->flexpwmp->SUB[sid].INTEN.B.RIE = 1;
      }
    }
  }
#endif

  /* Sets the MASK registers.*/
  pwmp->flexpwmp->SUB[sid].CTRL2.B.FRCEN = 1U;
  pwmp->flexpwmp->SUB[sid].CTRL2.B.FORCE = 1U;

  /* Forces reload of the VALUE registers.*/
  pwmp->flexpwmp->MCTRL.B.LDOK |= 1U << sid;
}

/**
 * @brief   Disables a PWM channel of a submodule.
 *
 * @param[in] pwmp      pointer to a @p PWMDriver object
 * @param[in] channel   PWM channel identifier (0...PWM_CHANNELS-1)
 * @param[in] sid       PWM submodule id
 *
 * @notapi
 */
void pwm_lld_disable_submodule_channel(PWMDriver *pwmp,
                                   pwmchannel_t channel,
                                   uint8_t sid) {

  pwmp->flexpwmp->MCTRL.B.CLDOK |= 1U << sid;

  /* Disables the width interrupt.*/
  if ((channel % 2) == 0) {
    if (pwmp->config->channels[channel].callback != NULL) {
      if ((pwmp->flexpwmp->SUB[sid].INTEN.B.CMPIE & 0x08) != 0) {
        pwmp->flexpwmp->SUB[sid].INTEN.B.CMPIE &= 0x37;
      }
    }

    /* Activates the channel mask.*/
    if ((pwmp->config->channels[channel].mode & PWM_COMPLEMENTARY_OUTPUT_MASK) != 0) {
      pwmp->flexpwmp->MASK.B.MASKA |= 1U << sid;
      pwmp->flexpwmp->MASK.B.MASKB |= 1U << sid;
    }
    else
      pwmp->flexpwmp->MASK.B.MASKA |= 1U << sid;
  }
  /* Disables the width interrupt.*/
  else {
    if (pwmp->config->channels[channel].callback != NULL) {
      if ((pwmp->flexpwmp->SUB[sid].INTEN.B.CMPIE & 0x20) != 0) {
        pwmp->flexpwmp->SUB[sid].INTEN.B.CMPIE &= 0x1F;
      }
    }

    /* Activates the channel mask.*/
    if ((pwmp->config->channels[channel].mode & PWM_COMPLEMENTARY_OUTPUT_MASK) != 0) {
      pwmp->flexpwmp->MASK.B.MASKA |= 1U << sid;
      pwmp->flexpwmp->MASK.B.MASKB |= 1U << sid;
    }
    else
      pwmp->flexpwmp->MASK.B.MASKB |= 1U << sid;
  }

  /* Sets the MASK registers.*/
  pwmp->flexpwmp->SUB[sid].CTRL2.B.FRCEN = 1U;
  pwmp->flexpwmp->SUB[sid].CTRL2.B.FORCE = 1U;

  /* Disables RIE interrupt to prevent reload interrupt.*/
  if ((pwmp->flexpwmp->MASK.B.MASKA & (1U << sid)) &&
      (pwmp->flexpwmp->MASK.B.MASKB & (1U << sid)) == 1) {
    pwmp->flexpwmp->SUB[sid].INTEN.B.RIE = 0;

    /* Clears the reload flag.*/
    pwmp->flexpwmp->SUB[sid].STS.B.RF = 1U;
  }

  pwmp->flexpwmp->MCTRL.B.LDOK |= (1U << sid);
}

/**
 * @brief   Common SMOD0...SMOD7 IRQ handler.
 * @note    It is assumed that the various sources are only activated if the
 *          associated callback pointer is not equal to @p NULL in order to not
 *          perform an extra check in a potentially critical interrupt handler.
 *
 * @param[in] pwmp      pointer to a @p PWMDriver object
 * @param[in] sid       PWM submodule id
 */
static void pwm_lld_serve_interrupt(PWMDriver *pwmp, uint8_t sid) {
  uint16_t sr;
  uint8_t cha;
  uint8_t chb;

/* Retrieve the channel a/b of the submodule sid when the channel
   synchronization is enabled.*/
#if !(SPC5_PWM0_USE_SYNC_SMOD) && !(SPC5_PWM1_USE_SYNC_SMOD)
  cha = 0;
  chb = 1;
#elif SPC5_PWM0_USE_SYNC_SMOD && !(SPC5_PWM1_USE_SYNC_SMOD)
  if (&PWMD1 == pwmp) {    
    cha = 2 * sid;
    chb = 2 * sid + 1;
  } else  {
    cha = 0;
    chb = 1;
  }
#elif !(SPC5_PWM0_USE_SYNC_SMOD) && SPC5_PWM1_USE_SYNC_SMOD
  if (&PWMD5 == pwmp) {
    cha = 2 * sid;
    chb = 2 * sid + 1;
  } else  {
    cha = 0;
    chb = 1;
  }
#else
  cha = 2 * sid;
  chb = 2 * sid + 1;
#endif

  sr = pwmp->flexpwmp->SUB[sid].STS.R & pwmp->flexpwmp->SUB[sid].INTEN.R;
  if ((sr & SPC5_FLEXPWM_STS_CMPF3) != 0) {
    pwmp->flexpwmp->SUB[sid].STS.B.CMPF |= 0x08;
    pwmp->config->channels[cha].callback(pwmp);
  }
  if ((sr & SPC5_FLEXPWM_STS_CMPF5) != 0) {
    pwmp->flexpwmp->SUB[sid].STS.B.CMPF |= 0x20;
    pwmp->config->channels[chb].callback(pwmp);
  }
  if ((sr & SPC5_FLEXPWM_STS_RF) != 0) {
    pwmp->flexpwmp->SUB[sid].STS.B.RF = 1U;
    pwmp->config->callback(pwmp);
  }
}

/*===========================================================================*/
/* Driver interrupt handlers.                                                */
/*===========================================================================*/

#if SPC5_PWM_USE_SMOD0 || defined(__DOXYGEN__)
#if !defined(SPC5_FLEXPWM0_RF0_HANDLER)
#error "SPC5_FLEXPWM0_RF0_HANDLER not defined"
#endif
/**
 * @brief   FlexPWM0-SMOD0 RF0 interrupt handler.
 *
 * @isr
 */
OSAL_IRQ_HANDLER(SPC5_FLEXPWM0_RF0_HANDLER) {

  OSAL_IRQ_PROLOGUE();

  pwm_lld_serve_interrupt(&PWMD1, 0);

  OSAL_IRQ_EPILOGUE();
}

#if !defined(SPC5_FLEXPWM0_COF0_HANDLER)
#error "SPC5_FLEXPWM0_COF0_HANDLER not defined"
#endif
/**
 * @brief   FlexPWM0-SMOD0 COF0 interrupt handler.
 *
 * @isr
 */
OSAL_IRQ_HANDLER(SPC5_FLEXPWM0_COF0_HANDLER) {

  OSAL_IRQ_PROLOGUE();

  pwm_lld_serve_interrupt(&PWMD1, 0);

  OSAL_IRQ_EPILOGUE();
}
#endif

#if SPC5_PWM_USE_SMOD1 || defined(__DOXYGEN__)
#if !(SPC5_PWM0_USE_SYNC_SMOD)
#if !defined(SPC5_FLEXPWM0_RF1_HANDLER)
#error "SPC5_FLEXPWM0_RF1_HANDLER not defined"
#endif
/**
 * @brief   FlexPWM0-SMOD1 RF1 interrupt handler.
 *
 * @isr
 */
OSAL_IRQ_HANDLER(SPC5_FLEXPWM0_RF1_HANDLER) {

  OSAL_IRQ_PROLOGUE();

  pwm_lld_serve_interrupt(&PWMD2, 1);

  OSAL_IRQ_EPILOGUE();
}
#endif

#if !defined(SPC5_FLEXPWM0_COF1_HANDLER)
#error "SPC5_FLEXPWM0_COF1_HANDLER not defined"
#endif
/**
 * @brief   FlexPWM0-SMOD1 COF1 interrupt handler.
 *
 * @isr
 */
OSAL_IRQ_HANDLER(SPC5_FLEXPWM0_COF1_HANDLER) {

  OSAL_IRQ_PROLOGUE();

#if !(SPC5_PWM0_USE_SYNC_SMOD)
  pwm_lld_serve_interrupt(&PWMD2, 1);
#else
  pwm_lld_serve_interrupt(&PWMD1, 1);
#endif

  OSAL_IRQ_EPILOGUE();
}
#endif

#if SPC5_PWM_USE_SMOD2 || defined(__DOXYGEN__)
#if !(SPC5_PWM0_USE_SYNC_SMOD)
#if !defined(SPC5_FLEXPWM0_RF2_HANDLER)
#error "SPC5_FLEXPWM0_RF2_HANDLER not defined"
#endif
/**
 * @brief   FlexPWM0-SMOD2 RF2 interrupt handler.
 *
 * @isr
 */
OSAL_IRQ_HANDLER(SPC5_FLEXPWM0_RF2_HANDLER) {

  OSAL_IRQ_PROLOGUE();

  pwm_lld_serve_interrupt(&PWMD3, 2);

  OSAL_IRQ_EPILOGUE();
}
#endif

#if !defined(SPC5_FLEXPWM0_COF2_HANDLER)
#error "SPC5_FLEXPWM0_COF2_HANDLER not defined"
#endif
/**
 * @brief   FlexPWM0-SMOD2 COF2 interrupt handler.
 *
 * @isr
 */
OSAL_IRQ_HANDLER(SPC5_FLEXPWM0_COF2_HANDLER) {

  OSAL_IRQ_PROLOGUE();

#if !(SPC5_PWM0_USE_SYNC_SMOD)
  pwm_lld_serve_interrupt(&PWMD3, 2);
#else
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
  INTC.PSR[SPC5_FLEXPWM1_COF1_NUMBER].R = SPC5_PWM_SMOD5_PRIORITY;
  INTC.PSR[SPC5_FLEXPWM1_CAF1_NUMBER].R = SPC5_PWM_SMOD5_PRIORITY;
  INTC.PSR[SPC5_FLEXPWM1_FFLAG_NUMBER].R = SPC5_PWM_SMOD5_PRIORITY;
  INTC.PSR[SPC5_FLEXPWM1_REF_NUMBER].R = SPC5_PWM_SMOD5_PRIORITY;
#endif

#if (SPC5_PWM_USE_SMOD6)
#if !(SPC5_PWM1_USE_SYNC_SMOD)
  /* Driver initialization.*/
  pwmObjectInit(&PWMD7);
  PWMD7.flexpwmp = &SPC5_FLEXPWM_1;
#endif
  INTC.PSR[SPC5_FLEXPWM1_RF2_NUMBER].R = SPC5_PWM_SMOD6_PRIORITY;
  INTC.PSR[SPC5_FLEXPWM1_COF2_NUMBER].R = SPC5_PWM_SMOD6_PRIORITY;
  INTC.PSR[SPC5_FLEXPWM1_CAF2_NUMBER].R = SPC5_PWM_SMOD6_PRIORITY;
  INTC.PSR[SPC5_FLEXPWM1_FFLAG_NUMBER].R = SPC5_PWM_SMOD6_PRIORITY;
  INTC.PSR[SPC5_FLEXPWM1_REF_NUMBER].R = SPC5_PWM_SMOD6_PRIORITY;
#endif

#if (SPC5_PWM_USE_SMOD7)
#if !(SPC5_PWM1_USE_SYNC_SMOD)
  /* Driver initialization.*/
  pwmObjectInit(&PWMD8);
  PWMD8.flexpwmp = &SPC5_FLEXPWM_1;
#endif
  INTC.PSR[SPC5_FLEXPWM1_RF3_NUMBER].R = SPC5_PWM_SMOD7_PRIORITY;
  INTC.PSR[SPC5_FLEXPWM1_COF3_NUMBER].R = SPC5_PWM_SMOD7_PRIORITY;
  INTC.PSR[SPC5_FLEXPWM1_CAF3_NUMBER].R = SPC5_PWM_SMOD7_PRIORITY;
  INTC.PSR[SPC5_FLEXPWM1_FFLAG_NUMBER].R = SPC5_PWM_SMOD7_PRIORITY;
  INTC.PSR[SPC5_FLEXPWM1_REF_NUMBER].R = SPC5_PWM_SMOD7_PRIORITY;
#endif
}

/**
 * @brief   Configures and activates the PWM peripheral.
 * @note    Starting a driver that is already in the @p PWM_READY state
 *          disables all the active channels.
 *
 * @param[in] pwmp      pointer to a @p PWMDriver object
 *
 * @notapi
 */
void pwm_lld_start(PWMDriver *pwmp) {

#if SPC5_PWM0_USE_SYNC_SMOD
  osalDbgAssert(flexpwm_active_submodules0 < 1, "too many submodules");
#else
  osalDbgAssert(flexpwm_active_submodules0 < 5, "too many submodules");
#endif

#if SPC5_PWM1_USE_SYNC_SMOD
  osalDbgAssert(flexpwm_active_submodules1 < 1, "too many submodules");
#else
  osalDbgAssert(flexpwm_active_submodules1 < 5, "too many submodules");
#endif

  if (pwmp->state == PWM_STOP) {
#if SPC5_PWM_USE_SMOD0
    if (&PWMD1 == pwmp) {
      flexpwm_active_submodules0++;
    }
#endif /* SPC5_PWM_USE_SMOD0 */

#if (SPC5_PWM_USE_SMOD1 && !(SPC5_PWM0_USE_SYNC_SMOD))
    if (&PWMD2 == pwmp) {
      flexpwm_active_submodules0++;
    }
#endif /* (SPC5_PWM_USE_SMOD1 && !(SPC5_PWM0_USE_SYNC_SMOD)) */

#if (SPC5_PWM_USE_SMOD2 && !(SPC5_PWM0_USE_SYNC_SMOD))
    if (&PWMD3 == pwmp) {
      flexpwm_active_submodules0++;
    }
#endif /* (SPC5_PWM_USE_SMOD2 && !(SPC5_PWM0_USE_SYNC_SMOD)) */

#if (SPC5_PWM_USE_SMOD3 && !(SPC5_PWM0_USE_SYNC_SMOD))
    if (&PWMD4 == pwmp) {
      flexpwm_active_submodules0++;
    }
#endif /* (SPC5_PWM_USE_SMOD3 && !(SPC5_PWM0_USE_SYNC_SMOD)) */

#if SPC5_PWM_USE_SMOD4
    if (&PWMD5 == pwmp) {
      flexpwm_active_submodules1++;
    }
#endif /* SPC5_PWM_USE_SMOD4 */

#if (SPC5_PWM_USE_SMOD5 && !(SPC5_PWM1_USE_SYNC_SMOD))
    if (&PWMD6 == pwmp) {
      flexpwm_active_submodules1++;
    }
#endif /* (SPC5_PWM_USE_SMOD5 && !(SPC5_PWM1_USE_SYNC_SMOD)) */

#if (SPC5_PWM_USE_SMOD6 && !(SPC5_PWM1_USE_SYNC_SMOD))
    if (&PWMD7 == pwmp) {
      flexpwm_active_submodules1++;
    }
#endif /* (SPC5_PWM_USE_SMOD6 && !(SPC5_PWM1_USE_SYNC_SMOD)) */

#if (SPC5_PWM_USE_SMOD7 && !(SPC5_PWM1_USE_SYNC_SMOD))
    if (&PWMD8 == pwmp) {
      flexpwm_active_submodules1++;
    }
#endif /* (SPC5_PWM_USE_SMOD7 && !(SPC5_PWM1_USE_SYNC_SMOD)) */

#if SPC5_PWM_USE_FLEXPWM0
    /* If this is the first FlexPWM0 submodule activated, sets Peripheral Clock.*/
    if (flexpwm_active_submodules0 == 1) {
      halSPCSetPeripheralClockMode(SPC5_FLEXPWM0_PCTL,
          SPC5_PWM_FLEXPWM0_START_PCTL);
    }
#endif

#if SPC5_PWM_USE_FLEXPWM1
    /* If this is the first FlexPWM1 submodule activated, sets Peripheral Clock.*/
    if (flexpwm_active_submodules1 == 1) {
      halSPCSetPeripheralClockMode(SPC5_FLEXPWM1_PCTL,
          SPC5_PWM_FLEXPWM1_START_PCTL);
    }
#endif

#if SPC5_PWM_USE_SMOD0
    if (&PWMD1 == pwmp) {
	  pwm_lld_start_submodule(pwmp, 0);
#if SPC5_PWM0_USE_SYNC_SMOD
      pwm_lld_start_submodule(pwmp, 1);
      pwm_lld_start_submodule(pwmp, 2);
      pwm_lld_start_submodule(pwmp, 3);
#endif
    }
#endif
#if (SPC5_PWM_USE_SMOD1 && !(SPC5_PWM0_USE_SYNC_SMOD))
    if (&PWMD2 == pwmp) {
      pwm_lld_start_submodule(pwmp, 1);
    }
#endif
#if (SPC5_PWM_USE_SMOD2 && !(SPC5_PWM0_USE_SYNC_SMOD))
    if (&PWMD3 == pwmp) {
      pwm_lld_start_submodule(pwmp, 2);
    }
#endif
#if (SPC5_PWM_USE_SMOD3 && !(SPC5_PWM0_USE_SYNC_SMOD))
    if (&PWMD4 == pwmp) {
      pwm_lld_start_submodule(pwmp, 3);
    }
#endif
#if SPC5_PWM_USE_SMOD4
    if (&PWMD5 == pwmp) {
	  pwm_lld_start_submodule(pwmp, 0);
#if SPC5_PWM1_USE_SYNC_SMOD
      pwm_lld_start_submodule(pwmp, 1);
      pwm_lld_start_submodule(pwmp, 2);
      pwm_lld_start_submodule(pwmp, 3);
#endif
    }
#endif
#if (SPC5_PWM_USE_SMOD5 && !(SPC5_PWM1_USE_SYNC_SMOD))
    if (&PWMD6 == pwmp) {
      pwm_lld_start_submodule(pwmp, 1);
    }
#endif
#if (SPC5_PWM_USE_SMOD6 && !(SPC5_PWM1_USE_SYNC_SMOD))
    if (&PWMD7 == pwmp) {
      pwm_lld_start_submodule(pwmp, 2);
    }
#endif
#if (SPC5_PWM_USE_SMOD7 && !(SPC5_PWM1_USE_SYNC_SMOD))
    if (&PWMD8 == pwmp) {
      pwm_lld_start_submodule(pwmp, 3);
    }
#endif
  }
  else {
    /* Driver re-configuration scenario, it must be stopped first.*/
#if SPC5_PWM_USE_SMOD0
    if (&PWMD1 == pwmp) {
      /* Disables the interrupts of submodule 0.*/
      pwmp->flexpwmp->SUB[0].INTEN.R = 0;

      /* Disables the submodule 0.*/
      pwmp->flexpwmp->OUTEN.B.PWMA_EN &= 0xE;
      pwmp->flexpwmp->OUTEN.B.PWMB_EN &= 0xE;

      /* Activates the submodule 0 masks.*/
      pwmp->flexpwmp->MASK.B.MASKA &= 0xE;
      pwmp->flexpwmp->MASK.B.MASKB &= 0xE;

      /* Sets the MASK registers of submodule 0.*/
      pwmp->flexpwmp->SUB[0].CTRL2.B.FRCEN = 1U;
      pwmp->flexpwmp->SUB[0].CTRL2.B.FORCE = 1U;
#if SPC5_PWM0_USE_SYNC_SMOD
      /* Disables the interrupts of submodules 1-3.*/
	  pwmp->flexpwmp->SUB[1].INTEN.R = 0;
	  pwmp->flexpwmp->SUB[2].INTEN.R = 0;
	  pwmp->flexpwmp->SUB[3].INTEN.R = 0;
 
      /* Disables the submodules 1-3.*/
      pwmp->flexpwmp->OUTEN.B.PWMA_EN &= 0x1;
      pwmp->flexpwmp->OUTEN.B.PWMB_EN &= 0x1;

      /* Activates the masks of submodules 1-3.*/
      pwmp->flexpwmp->MASK.B.MASKA &= 0x1;
      pwmp->flexpwmp->MASK.B.MASKB &= 0x1;

      /* Sets the MASK registers of submodules 1-3.*/
      pwmp->flexpwmp->SUB[1].CTRL2.B.FRCEN = 1U;
      pwmp->flexpwmp->SUB[1].CTRL2.B.FORCE = 1U;
      pwmp->flexpwmp->SUB[2].CTRL2.B.FRCEN = 1U;
      pwmp->flexpwmp->SUB[2].CTRL2.B.FORCE = 1U;
      pwmp->flexpwmp->SUB[3].CTRL2.B.FRCEN = 1U;
      pwmp->flexpwmp->SUB[3].CTRL2.B.FORCE = 1U;
#endif
    }
#endif
#if (SPC5_PWM_USE_SMOD1 && !(SPC5_PWM0_USE_SYNC_SMOD))
    if (&PWMD2 == pwmp) {
      /* Disables the interrupts of submodule 1.*/
      pwmp->flexpwmp->SUB[1].INTEN.R = 0;

      /* Disables the submodule 1.*/
      pwmp->flexpwmp->OUTEN.B.PWMA_EN &= 0xD;
      pwmp->flexpwmp->OUTEN.B.PWMB_EN &= 0xD;

      /* Activates the submodule 1 masks.*/
      pwmp->flexpwmp->MASK.B.MASKA &= 0xD;
      pwmp->flexpwmp->MASK.B.MASKB &= 0xD;

      /* Sets the MASK registers of submodule 1.*/
      pwmp->flexpwmp->SUB[1].CTRL2.B.FRCEN = 1U;
      pwmp->flexpwmp->SUB[1].CTRL2.B.FORCE = 1U;
    }
#endif
#if (SPC5_PWM_USE_SMOD2 && !(SPC5_PWM0_USE_SYNC_SMOD))
    if (&PWMD3 == pwmp) {
      /* Disables the interrupts of submodule 2.*/
      pwmp->flexpwmp->SUB[2].INTEN.R = 0;

      /* Disables the submodule 2.*/
      pwmp->flexpwmp->OUTEN.B.PWMA_EN &= 0xB;
      pwmp->flexpwmp->OUTEN.B.PWMB_EN &= 0xB;

      /* Activates the submodule 2 masks.*/
      pwmp->flexpwmp->MASK.B.MASKA &= 0xB;
      pwmp->flexpwmp->MASK.B.MASKB &= 0xB;

      /* Sets the MASK registers of submodule 2.*/
      pwmp->flexpwmp->SUB[2].CTRL2.B.FRCEN = 1U;
      pwmp->flexpwmp->SUB[2].CTRL2.B.FORCE = 1U;
    }
#endif
#if (SPC5_PWM_USE_SMOD3 && !(SPC5_PWM0_USE_SYNC_SMOD))
    if (&PWMD4 == pwmp) {
      /* Disables the interrupts of submodule 3.*/
      pwmp->flexpwmp->SUB[3].INTEN.R = 0;

      /* Disables the submodule 3.*/
      pwmp->flexpwmp->OUTEN.B.PWMA_EN &= 0x7;
      pwmp->flexpwmp->OUTEN.B.PWMB_EN &= 0x7;

      /* Activates the submodule 3 masks.*/
      pwmp->flexpwmp->MASK.B.MASKA &= 0x7;
      pwmp->flexpwmp->MASK.B.MASKB &= 0x7;

      /* Sets the MASK registers of submodule 3.*/
      pwmp->flexpwmp->SUB[3].CTRL2.B.FRCEN = 1U;
      pwmp->flexpwmp->SUB[3].CTRL2.B.FORCE = 1U;
    }
#endif
#if SPC5_PWM_USE_SMOD4
    if (&PWMD5 == pwmp) {
      /* Disables the interrupts of submodule 0.*/
      pwmp->flexpwmp->SUB[0].INTEN.R = 0;

      /* Disables the submodule 0.*/
      pwmp->flexpwmp->OUTEN.B.PWMA_EN &= 0xE;
      pwmp->flexpwmp->OUTEN.B.PWMB_EN &= 0xE;

      /* Activates the submodule 0 masks.*/
      pwmp->flexpwmp->MASK.B.MASKA &= 0xE;
      pwmp->flexpwmp->MASK.B.MASKB &= 0xE;

      /* Sets the MASK registers of submodule 0.*/
      pwmp->flexpwmp->SUB[0].CTRL2.B.FRCEN = 1U;
      pwmp->flexpwmp->SUB[0].CTRL2.B.FORCE = 1U;
#if SPC5_PWM1_USE_SYNC_SMOD
      /* Disables the interrupts of submodules 1-3.*/
	  pwmp->flexpwmp->SUB[1].INTEN.R = 0;
	  pwmp->flexpwmp->SUB[2].INTEN.R = 0;
	  pwmp->flexpwmp->SUB[3].INTEN.R = 0;
 
      /* Disables the submodules 1-3.*/
      pwmp->flexpwmp->OUTEN.B.PWMA_EN &= 0x1;
      pwmp->flexpwmp->OUTEN.B.PWMB_EN &= 0x1;

      /* Activates the masks of submodules 1-3.*/
      pwmp->flexpwmp->MASK.B.MASKA &= 0x1;
      pwmp->flexpwmp->MASK.B.MASKB &= 0x1;

      /* Sets the MASK registers of submodules 1-3.*/
      pwmp->flexpwmp->SUB[1].CTRL2.B.FRCEN = 1U;
      pwmp->flexpwmp->SUB[1].CTRL2.B.FORCE = 1U;
      pwmp->flexpwmp->SUB[2].CTRL2.B.FRCEN = 1U;
      pwmp->flexpwmp->SUB[2].CTRL2.B.FORCE = 1U;
      pwmp->flexpwmp->SUB[3].CTRL2.B.FRCEN = 1U;
      pwmp->flexpwmp->SUB[3].CTRL2.B.FORCE = 1U;
#endif
    }
#endif
#if (SPC5_PWM_USE_SMOD5 && !(SPC5_PWM1_USE_SYNC_SMOD))
    if (&PWMD6 == pwmp) {
      /* Disables the interrupts of submodule 1.*/
      pwmp->flexpwmp->SUB[1].INTEN.R = 0;

      /* Disables the submodule 1.*/
      pwmp->flexpwmp->OUTEN.B.PWMA_EN &= 0xD;
      pwmp->flexpwmp->OUTEN.B.PWMB_EN &= 0xD;

      /* Activates the submodule 1 masks.*/
      pwmp->flexpwmp->MASK.B.MASKA &= 0xD;
      pwmp->flexpwmp->MASK.B.MASKB &= 0xD;

      /* Sets the MASK registers of submodule 1.*/
      pwmp->flexpwmp->SUB[1].CTRL2.B.FRCEN = 1U;
      pwmp->flexpwmp->SUB[1].CTRL2.B.FORCE = 1U;
    }
#endif
#if (SPC5_PWM_USE_SMOD6 && !(SPC5_PWM1_USE_SYNC_SMOD))
    if (&PWMD7 == pwmp) {
      /* Disables the interrupts of submodule 2.*/
      pwmp->flexpwmp->SUB[2].INTEN.R = 0;

      /* Disables the submodule 2.*/
      pwmp->flexpwmp->OUTEN.B.PWMA_EN &= 0xB;
      pwmp->flexpwmp->OUTEN.B.PWMB_EN &= 0xB;

      /* Activates the submodule 2 masks.*/
      pwmp->flexpwmp->MASK.B.MASKA &= 0xB;
      pwmp->flexpwmp->MASK.B.MASKB &= 0xB;

      /* Sets the MASK registers of submodule 2.*/
      pwmp->flexpwmp->SUB[2].CTRL2.B.FRCEN = 1U;
      pwmp->flexpwmp->SUB[2].CTRL2.B.FORCE = 1U;
    }
#endif
#if (SPC5_PWM_USE_SMOD7 && !(SPC5_PWM1_USE_SYNC_SMOD))
    if (&PWMD8 == pwmp) {
      /* Disables the interrupts of submodule 3.*/
      pwmp->flexpwmp->SUB[3].INTEN.R = 0;

      /* Disables the submodule 3.*/
      pwmp->flexpwmp->OUTEN.B.PWMA_EN &= 0x7;
      pwmp->flexpwmp->OUTEN.B.PWMB_EN &= 0x7;

      /* Activates the submodule 3 masks.*/
      pwmp->flexpwmp->MASK.B.MASKA &= 0x7;
      pwmp->flexpwmp->MASK.B.MASKB &= 0x7;

      /* Sets the MASK registers of submodule 3.*/
      pwmp->flexpwmp->SUB[3].CTRL2.B.FRCEN = 1U;
      pwmp->flexpwmp->SUB[3].CTRL2.B.FORCE = 1U;
    }
#endif
  }
}

/**
 * @brief   Deactivates the PWM peripheral.
 *
 * @param[in] pwmp      pointer to a @p PWMDriver object
 *
 * @notapi
 */
void pwm_lld_stop(PWMDriver *pwmp) {

#if SPC5_PWM0_USE_SYNC_SMOD
  osalDbgAssert(flexpwm_active_submodules0 < 1, "too many submodules");
#else
  osalDbgAssert(flexpwm_active_submodules0 < 5, "too many submodules");
#endif

#if SPC5_PWM1_USE_SYNC_SMOD
  osalDbgAssert(flexpwm_active_submodules1 < 1, "too many submodules");
#else
  osalDbgAssert(flexpwm_active_submodules1 < 5, "too many submodules");
#endif

  /* If in ready state then disables the PWM clock.*/
  if (pwmp->state == PWM_READY) {

#if SPC5_PWM_USE_SMOD0
    if (&PWMD1 == pwmp) {
      flexpwm_active_submodules0--;
    }
#endif /* SPC5_PWM_USE_SMOD0 */

#if (SPC5_PWM_USE_SMOD1 && !(SPC5_PWM0_USE_SYNC_SMOD))
    if (&PWMD2 == pwmp) {
      flexpwm_active_submodules0--;
    }
#endif /* (SPC5_PWM_USE_SMOD1 && !(SPC5_PWM0_USE_SYNC_SMOD)) */

#if (SPC5_PWM_USE_SMOD2 && !(SPC5_PWM0_USE_SYNC_SMOD))
    if (&PWMD3 == pwmp) {
      flexpwm_active_submodules0--;
    }
#endif /* (SPC5_PWM_USE_SMOD2 && !(SPC5_PWM0_USE_SYNC_SMOD)) */

#if (SPC5_PWM_USE_SMOD3 && !(SPC5_PWM0_USE_SYNC_SMOD))
    if (&PWMD4 == pwmp) {
      flexpwm_active_submodules0--;
    }
#endif /* (SPC5_PWM_USE_SMOD3 && !(SPC5_PWM0_USE_SYNC_SMOD)) */

#if SPC5_PWM_USE_SMOD4
    if (&PWMD5 == pwmp) {
      flexpwm_active_submodules1--;
    }
#endif /* SPC5_PWM_USE_SMOD4 */

#if (SPC5_PWM_USE_SMOD5 && !(SPC5_PWM1_USE_SYNC_SMOD))
    if (&PWMD6 == pwmp) {
      flexpwm_active_submodules1--;
    }
#endif /* (SPC5_PWM_USE_SMOD5 && !(SPC5_PWM1_USE_SYNC_SMOD)) */

#if (SPC5_PWM_USE_SMOD6 && !(SPC5_PWM1_USE_SYNC_SMOD))
    if (&PWMD7 == pwmp) {
      flexpwm_active_submodules1--;
    }
#endif /* (SPC5_PWM_USE_SMOD6 && !(SPC5_PWM1_USE_SYNC_SMOD)) */

#if (SPC5_PWM_USE_SMOD7 && !(SPC5_PWM1_USE_SYNC_SMOD))
    if (&PWMD8 == pwmp) {
      flexpwm_active_submodules1--;
    }
#endif /* (SPC5_PWM_USE_SMOD7 && !(SPC5_PWM1_USE_SYNC_SMOD)) */

#if SPC5_PWM_USE_SMOD0
    if (&PWMD1 == pwmp) {
      /* FlexPWM0 SMOD 0 stop.*/
      pwmp->flexpwmp->MCTRL.B.CLDOK |= 1U;
      pwmp->flexpwmp->SUB[0].INTEN.R = 0;
      pwmp->flexpwmp->SUB[0].STS.R = 0xFFFF;
      pwmp->flexpwmp->OUTEN.B.PWMA_EN &= 0xE;
      pwmp->flexpwmp->OUTEN.B.PWMB_EN &= 0xE;

      pwmp->flexpwmp->MCTRL.B.RUN &= 0xE;
#if SPC5_PWM0_USE_SYNC_SMOD
      /* FlexPWM0 SMOD 1-3 stop.*/
      pwmp->flexpwmp->MCTRL.B.CLDOK |= 0xE;
      pwmp->flexpwmp->SUB[1].INTEN.R = 0;
      pwmp->flexpwmp->SUB[1].STS.R = 0xFFFF;
      pwmp->flexpwmp->SUB[2].INTEN.R = 0;
      pwmp->flexpwmp->SUB[2].STS.R = 0xFFFF;
      pwmp->flexpwmp->SUB[3].INTEN.R = 0;
      pwmp->flexpwmp->SUB[3].STS.R = 0xFFFF;
      pwmp->flexpwmp->OUTEN.B.PWMA_EN &= 0x1;
      pwmp->flexpwmp->OUTEN.B.PWMB_EN &= 0x1;

      pwmp->flexpwmp->MCTRL.B.RUN &= 0x1;
#endif
    }
#endif
#if (SPC5_PWM_USE_SMOD1 && !(SPC5_PWM0_USE_SYNC_SMOD))
    if (&PWMD2 == pwmp) {
      /* FlexPWM0 SMOD 1 stop.*/
      pwmp->flexpwmp->MCTRL.B.CLDOK |= 2U;
      pwmp->flexpwmp->SUB[1].INTEN.R = 0;
      pwmp->flexpwmp->SUB[1].STS.R = 0xFFFF;
      pwmp->flexpwmp->OUTEN.B.PWMA_EN &= 0xD;
      pwmp->flexpwmp->OUTEN.B.PWMB_EN &= 0xD;

      pwmp->flexpwmp->MCTRL.B.RUN &= 0xD;
    }
#endif
#if (SPC5_PWM_USE_SMOD2 && !(SPC5_PWM0_USE_SYNC_SMOD))
    if (&PWMD3 == pwmp) {
      /* FlexPWM0 SMOD 2 stop.*/
      pwmp->flexpwmp->MCTRL.B.CLDOK |= 4U;
      pwmp->flexpwmp->SUB[2].INTEN.R = 0;
      pwmp->flexpwmp->SUB[2].STS.R = 0xFFFF;
      pwmp->flexpwmp->OUTEN.B.PWMA_EN &= 0xB;
      pwmp->flexpwmp->OUTEN.B.PWMB_EN &= 0xB;

      pwmp->flexpwmp->MCTRL.B.RUN &= 0xB;
    }
#endif
#if (SPC5_PWM_USE_SMOD3 && !(SPC5_PWM0_USE_SYNC_SMOD))
    if (&PWMD4 == pwmp) {
      /* FlexPWM0 SMOD 3 stop.*/
      pwmp->flexpwmp->MCTRL.B.CLDOK |= 8U;
      pwmp->flexpwmp->SUB[3].INTEN.R = 0;
      pwmp->flexpwmp->SUB[3].STS.R = 0xFFFF;
      pwmp->flexpwmp->OUTEN.B.PWMA_EN &= 0x7;
      pwmp->flexpwmp->OUTEN.B.PWMB_EN &= 0x7;

      pwmp->flexpwmp->MCTRL.B.RUN &= 0x7;
    }
#endif
#if SPC5_PWM_USE_SMOD4
    if (&PWMD5 == pwmp) {
      /* FlexPWM1 SMOD 0 stop.*/
      pwmp->flexpwmp->MCTRL.B.CLDOK |= 1U;
      pwmp->flexpwmp->SUB[0].INTEN.R = 0;
      pwmp->flexpwmp->SUB[0].STS.R = 0xFFFF;
      pwmp->flexpwmp->OUTEN.B.PWMA_EN &= 0xE;
      pwmp->flexpwmp->OUTEN.B.PWMB_EN &= 0xE;

      pwmp->flexpwmp->MCTRL.B.RUN &= 0xE;
#if SPC5_PWM1_USE_SYNC_SMOD
      /* FlexPWM1 SMOD 1-3 stop.*/
      pwmp->flexpwmp->MCTRL.B.CLDOK |= 0xE;
      pwmp->flexpwmp->SUB[1].INTEN.R = 0;
      pwmp->flexpwmp->SUB[1].STS.R = 0xFFFF;
      pwmp->flexpwmp->SUB[2].INTEN.R = 0;
      pwmp->flexpwmp->SUB[2].STS.R = 0xFFFF;
      pwmp->flexpwmp->SUB[3].INTEN.R = 0;
      pwmp->flexpwmp->SUB[3].STS.R = 0xFFFF;
      pwmp->flexpwmp->OUTEN.B.PWMA_EN &= 0x1;
      pwmp->flexpwmp->OUTEN.B.PWMB_EN &= 0x1;

      pwmp->flexpwmp->MCTRL.B.RUN &= 0x1;
#endif
    }
#endif
#if (SPC5_PWM_USE_SMOD5 && !(SPC5_PWM1_USE_SYNC_SMOD))
    if (&PWMD6 == pwmp) {
      /* FlexPWM1 SMOD 1 stop.*/
      pwmp->flexpwmp->MCTRL.B.CLDOK |= 2U;
      pwmp->flexpwmp->SUB[1].INTEN.R = 0;
      pwmp->flexpwmp->SUB[1].STS.R = 0xFFFF;
      pwmp->flexpwmp->OUTEN.B.PWMA_EN &= 0xD;
      pwmp->flexpwmp->OUTEN.B.PWMB_EN &= 0xD;

      pwmp->flexpwmp->MCTRL.B.RUN &= 0xD;
    }
#endif
#if (SPC5_PWM_USE_SMOD6 && !(SPC5_PWM1_USE_SYNC_SMOD))
    if (&PWMD7 == pwmp) {
      /* FlexPWM1 SMOD 2 stop.*/
      pwmp->flexpwmp->MCTRL.B.CLDOK |= 4U;
      pwmp->flexpwmp->SUB[2].INTEN.R = 0;
      pwmp->flexpwmp->SUB[2].STS.R = 0xFFFF;
      pwmp->flexpwmp->OUTEN.B.PWMA_EN &= 0xB;
      pwmp->flexpwmp->OUTEN.B.PWMB_EN &= 0xB;

      pwmp->flexpwmp->MCTRL.B.RUN &= 0xB;
    }
#endif
#if (SPC5_PWM_USE_SMOD7 && !(SPC5_PWM1_USE_SYNC_SMOD))
    if (&PWMD8 == pwmp) {
      /* FlexPWM1 SMOD 3 stop.*/
      pwmp->flexpwmp->MCTRL.B.CLDOK |= 8U;
      pwmp->flexpwmp->SUB[3].INTEN.R = 0;
      pwmp->flexpwmp->SUB[3].STS.R = 0xFFFF;
      pwmp->flexpwmp->OUTEN.B.PWMA_EN &= 0x7;
      pwmp->flexpwmp->OUTEN.B.PWMB_EN &= 0x7;

      pwmp->flexpwmp->MCTRL.B.RUN &= 0x7;
    }
#endif

#if SPC5_PWM_USE_FLEXPWM0
    /* Disables peripheral clock if there is not an activated module.*/
    if (flexpwm_active_submodules0 == 0) {
      halSPCSetPeripheralClockMode(SPC5_FLEXPWM0_PCTL,
                                   SPC5_PWM_FLEXPWM0_STOP_PCTL);
    }
#endif

#if SPC5_PWM_USE_FLEXPWM1
    /* Disables peripheral clock if there is not an activated module.*/
    if (flexpwm_active_submodules1 == 0) {
      halSPCSetPeripheralClockMode(SPC5_FLEXPWM1_PCTL,
                                   SPC5_PWM_FLEXPWM1_STOP_PCTL);
    }
#endif

  }
}

/**
 * @brief   Enables a PWM channel.
 * @pre     The PWM unit must have been activated using @p pwmStart().
 * @post    The channel is active using the specified configuration.
 * @note    The function has effect at the next cycle start.
 *
 * @param[in] pwmp      pointer to a @p PWMDriver object
 * @param[in] channel   PWM channel identifier (0...PWM_CHANNELS-1)
 * @param[in] width     PWM pulse width as clock pulses number
 *
 * @notapi
 */
void pwm_lld_enable_channel(PWMDriver *pwmp,
                            pwmchannel_t channel,
                            pwmcnt_t width) {

#if SPC5_PWM_USE_SMOD0
  if (&PWMD1 == pwmp) {
#if SPC5_PWM0_USE_SYNC_SMOD
    pwm_lld_enable_submodule_channel(pwmp, channel, width, channel/2);
#else
    pwm_lld_enable_submodule_channel(pwmp, channel, width, 0);
#endif
  }
#endif
#if (SPC5_PWM_USE_SMOD1 && !(SPC5_PWM0_USE_SYNC_SMOD))
  if (&PWMD2 == pwmp) {
    pwm_lld_enable_submodule_channel(pwmp, channel, width, 1);
  }
#endif
#if (SPC5_PWM_USE_SMOD2 && !(SPC5_PWM0_USE_SYNC_SMOD))
  if (&PWMD3 == pwmp) {
    pwm_lld_enable_submodule_channel(pwmp, channel, width, 2);
  }
#endif
#if (SPC5_PWM_USE_SMOD3 && !(SPC5_PWM0_USE_SYNC_SMOD))
  if (&PWMD4 == pwmp) {
    pwm_lld_enable_submodule_channel(pwmp, channel, width, 3);
  }
#endif
#if SPC5_PWM_USE_SMOD4
  if (&PWMD5 == pwmp) {
#if SPC5_PWM1_USE_SYNC_SMOD
    pwm_lld_enable_submodule_channel(pwmp, channel, width, channel/2);
#else
    pwm_lld_enable_submodule_channel(pwmp, channel, width, 0);
#endif
  }
#endif
#if (SPC5_PWM_USE_SMOD5 && !(SPC5_PWM1_USE_SYNC_SMOD))
  if (&PWMD6 == pwmp) {
    pwm_lld_enable_submodule_channel(pwmp, channel, width, 1);
  }
#endif
#if (SPC5_PWM_USE_SMOD6 && !(SPC5_PWM1_USE_SYNC_SMOD))
  if (&PWMD7 == pwmp) {
    pwm_lld_enable_submodule_channel(pwmp, channel, width, 2);
  }
#endif
#if (SPC5_PWM_USE_SMOD7 && !(SPC5_PWM1_USE_SYNC_SMOD))
  if (&PWMD8 == pwmp) {
    pwm_lld_enable_submodule_channel(pwmp, channel, width, 3);
  }
#endif
}

/**
 * @brief   Disables a PWM channel.
 * @pre     The PWM unit must have been activated using @p pwmStart().
 * @post    The channel is disabled and its output line returned to the
 *          idle state.
 * @note    The function has effect at the next cycle start.
 *
 * @param[in] pwmp      pointer to a @p PWMDriver object
 * @param[in] channel   PWM channel identifier (0...PWM_CHANNELS-1)
 *
 * @notapi
 */
void pwm_lld_disable_channel(PWMDriver *pwmp, pwmchannel_t channel) {

#if SPC5_PWM_USE_SMOD0
  if (&PWMD1 == pwmp) {
#if SPC5_PWM0_USE_SYNC_SMOD
    pwm_lld_disable_submodule_channel(pwmp, channel, channel/2);
#else
    pwm_lld_disable_submodule_channel(pwmp, channel, 0);
#endif
  }
#endif
#if (SPC5_PWM_USE_SMOD1 && !(SPC5_PWM0_USE_SYNC_SMOD))
  if (&PWMD2 == pwmp) {
    pwm_lld_disable_submodule_channel(pwmp, channel, 1);
  }
#endif
#if (SPC5_PWM_USE_SMOD2 && !(SPC5_PWM0_USE_SYNC_SMOD))
  if (&PWMD3 == pwmp) {
    pwm_lld_disable_submodule_channel(pwmp, channel, 2);
  }
#endif
#if (SPC5_PWM_USE_SMOD3 && !(SPC5_PWM0_USE_SYNC_SMOD))
  if (&PWMD4 == pwmp) {
    pwm_lld_disable_submodule_channel(pwmp, channel, 3);
  }
#endif
#if SPC5_PWM_USE_SMOD4
  if (&PWMD5 == pwmp) {
#if SPC5_PWM1_USE_SYNC_SMOD
    pwm_lld_disable_submodule_channel(pwmp, channel, channel/2);
#else
    pwm_lld_disable_submodule_channel(pwmp, channel, 0);
#endif
  }
#endif
#if (SPC5_PWM_USE_SMOD5 && !(SPC5_PWM1_USE_SYNC_SMOD))
  if (&PWMD6 == pwmp) {
    pwm_lld_disable_submodule_channel(pwmp, channel, 1);
  }
#endif
#if (SPC5_PWM_USE_SMOD6 && !(SPC5_PWM1_USE_SYNC_SMOD))
  if (&PWMD7 == pwmp) {
    pwm_lld_disable_submodule_channel(pwmp, channel, 2);
  }
#endif
#if (SPC5_PWM_USE_SMOD7 && !(SPC5_PWM1_USE_SYNC_SMOD))
  if (&PWMD8 == pwmp) {
    pwm_lld_disable_submodule_channel(pwmp, channel, 3);
  }
#endif
}

/**
 * @brief   Changes the period the PWM peripheral.
 * @details This function changes the period of a PWM unit that has already
 *          been activated using @p pwmStart().
 * @pre     The PWM unit must have been activated using @p pwmStart().
 * @post    The PWM unit period is changed to the new value.
 * @note    The function has effect at the next cycle start.
 * @note    If a period is specified that is shorter than the pulse width
 *          programmed in one of the channels then the behavior is not
 *          guaranteed.
 *
 * @param[in] pwmp      pointer to a @p PWMDriver object
 * @param[in] period    new cycle time in ticks
 *
 * @notapi
 */
void pwm_lld_change_period(PWMDriver *pwmp, pwmcnt_t period) {

  pwmcnt_t pwmperiod = period;
#if SPC5_PWM_USE_SMOD0
  if (&PWMD1 == pwmp) {
    pwmp->flexpwmp->MCTRL.B.CLDOK |= 1U;

    /* Setting PWM period of submodule 0.*/
    pwmp->flexpwmp->SUB[0].INIT.R = ~(pwmperiod / 2) + 1U;
    pwmp->flexpwmp->SUB[0].VAL[0].R = 0;
    pwmp->flexpwmp->SUB[0].VAL[1].R = pwmperiod / 2;

    switch (pwmp->config->mode & PWM_ALIGN_MASK) {
    case PWM_ALIGN_EDGE:
      /* Setting active front of PWM channels of submodule 0.*/
      pwmp->flexpwmp->SUB[0].VAL[2].R = ~(pwmperiod / 2) + 1U;
      pwmp->flexpwmp->SUB[0].VAL[4].R = ~(pwmperiod / 2) + 1U;
      break;
    default:
      ;
    }
    pwmp->flexpwmp->MCTRL.B.LDOK |= 1U;
#if SPC5_PWM0_USE_SYNC_SMOD
    pwmp->flexpwmp->MCTRL.B.RUN &= 0x1;
    pwmp->flexpwmp->MCTRL.B.CLDOK |= 0xE;

    /* Setting PWM period of submodules 1-3.*/
    pwmp->flexpwmp->SUB[1].INIT.R = ~(pwmperiod / 2) + 1U;
    pwmp->flexpwmp->SUB[1].VAL[0].R = 0;
    pwmp->flexpwmp->SUB[1].VAL[1].R = pwmperiod / 2;
	pwmp->flexpwmp->SUB[2].INIT.R = ~(pwmperiod / 2) + 1U;
    pwmp->flexpwmp->SUB[2].VAL[0].R = 0;
    pwmp->flexpwmp->SUB[2].VAL[1].R = pwmperiod / 2;
    pwmp->flexpwmp->SUB[3].INIT.R = ~(pwmperiod / 2) + 1U;
    pwmp->flexpwmp->SUB[3].VAL[0].R = 0;
    pwmp->flexpwmp->SUB[3].VAL[1].R = pwmperiod / 2;

    switch (pwmp->config->mode & PWM_ALIGN_MASK) {
    case PWM_ALIGN_EDGE:
      /* Setting active front of PWM channels of submodules 1-3.*/
	  pwmp->flexpwmp->SUB[1].VAL[2].R = ~(pwmperiod / 2) + 1U;
      pwmp->flexpwmp->SUB[1].VAL[4].R = ~(pwmperiod / 2) + 1U;
	  pwmp->flexpwmp->SUB[2].VAL[2].R = ~(pwmperiod / 2) + 1U;
      pwmp->flexpwmp->SUB[2].VAL[4].R = ~(pwmperiod / 2) + 1U;
	  pwmp->flexpwmp->SUB[3].VAL[2].R = ~(pwmperiod / 2) + 1U;
      pwmp->flexpwmp->SUB[3].VAL[4].R = ~(pwmperiod / 2) + 1U;
      break;
    default:
      ;
    }
    pwmp->flexpwmp->MCTRL.B.LDOK |= 0xE;
    pwmp->flexpwmp->MCTRL.B.RUN |= 0xE;
#endif
  }
#endif
#if (SPC5_PWM_USE_SMOD1 && !(SPC5_PWM0_USE_SYNC_SMOD))
  if (&PWMD2 == pwmp) {
    pwmp->flexpwmp->MCTRL.B.CLDOK |= 2U;

    /* Setting PWM period of submodule 1.*/
    pwmp->flexpwmp->SUB[1].INIT.R = ~(pwmperiod / 2) + 1U;
    pwmp->flexpwmp->SUB[1].VAL[0].R = 0;
    pwmp->flexpwmp->SUB[1].VAL[1].R = pwmperiod / 2;

    switch (pwmp->config->mode & PWM_ALIGN_MASK) {
    case PWM_ALIGN_EDGE:

      /* Setting active front of PWM channels of submodule 1.*/
      pwmp->flexpwmp->SUB[1].VAL[2].R = ~(pwmperiod / 2) + 1U;
      pwmp->flexpwmp->SUB[1].VAL[4].R = ~(pwmperiod / 2) + 1U;
      break;
    default:
      ;
    }
    pwmp->flexpwmp->MCTRL.B.LDOK |= 2U;
  }
#endif
#if (SPC5_PWM_USE_SMOD2 && !(SPC5_PWM0_USE_SYNC_SMOD))
  if (&PWMD3 == pwmp) {
    pwmp->flexpwmp->MCTRL.B.CLDOK |= 4U;

    /* Setting PWM period of submodule 2.*/
    pwmp->flexpwmp->SUB[2].INIT.R = ~(pwmperiod / 2) + 1U;
    pwmp->flexpwmp->SUB[2].VAL[0].R = 0;
    pwmp->flexpwmp->SUB[2].VAL[1].R = pwmperiod / 2;

    switch (pwmp->config->mode & PWM_ALIGN_MASK) {
    case PWM_ALIGN_EDGE:
      /* Setting active front of PWM channels of submodule 2.*/
      pwmp->flexpwmp->SUB[2].VAL[2].R = ~(pwmperiod / 2) + 1U;
      pwmp->flexpwmp->SUB[2].VAL[4].R = ~(pwmperiod / 2) + 1U;
      break;
    default:
      ;
    }
    pwmp->flexpwmp->MCTRL.B.LDOK |= 4U;
  }
#endif
#if (SPC5_PWM_USE_SMOD3 && !(SPC5_PWM0_USE_SYNC_SMOD))
  if (&PWMD4 == pwmp) {
    pwmp->flexpwmp->MCTRL.B.CLDOK |= 8U;

    /* Setting PWM period of submodule 3.*/
    pwmp->flexpwmp->SUB[3].INIT.R = ~(pwmperiod / 2) + 1U;
    pwmp->flexpwmp->SUB[3].VAL[0].R = 0;
    pwmp->flexpwmp->SUB[3].VAL[1].R = pwmperiod / 2;

    switch (pwmp->config->mode & PWM_ALIGN_MASK) {
    case PWM_ALIGN_EDGE:
      /* Setting active front of PWM channels of submodule 3.*/
      pwmp->flexpwmp->SUB[3].VAL[2].R = ~(pwmperiod / 2) + 1U;
      pwmp->flexpwmp->SUB[3].VAL[4].R = ~(pwmperiod / 2) + 1U;
      break;
    default:
      ;
    }
    pwmp->flexpwmp->MCTRL.B.LDOK |= 8U;
  }
#endif
#if SPC5_PWM_USE_SMOD4
  if (&PWMD5 == pwmp) {
    pwmp->flexpwmp->MCTRL.B.CLDOK |= 1U;

    /* Setting PWM period of submodule 0.*/
    pwmp->flexpwmp->SUB[0].INIT.R = ~(pwmperiod / 2) + 1U;
    pwmp->flexpwmp->SUB[0].VAL[0].R = 0;
    pwmp->flexpwmp->SUB[0].VAL[1].R = pwmperiod / 2;

    switch (pwmp->config->mode & PWM_ALIGN_MASK) {
    case PWM_ALIGN_EDGE:
      /* Setting active front of PWM channels of submodule 0.*/
      pwmp->flexpwmp->SUB[0].VAL[2].R = ~(pwmperiod / 2) + 1U;
      pwmp->flexpwmp->SUB[0].VAL[4].R = ~(pwmperiod / 2) + 1U;
      break;
    default:
      ;
    }
    pwmp->flexpwmp->MCTRL.B.LDOK |= 1U;
#if SPC5_PWM1_USE_SYNC_SMOD
    pwmp->flexpwmp->MCTRL.B.CLDOK |= 0xE;

    /* Setting PWM period of submodules 1-3.*/
    pwmp->flexpwmp->SUB[1].INIT.R = ~(pwmperiod / 2) + 1U;
    pwmp->flexpwmp->SUB[1].VAL[0].R = 0;
    pwmp->flexpwmp->SUB[1].VAL[1].R = pwmperiod / 2;
	pwmp->flexpwmp->SUB[2].INIT.R = ~(pwmperiod / 2) + 1U;
    pwmp->flexpwmp->SUB[2].VAL[0].R = 0;
    pwmp->flexpwmp->SUB[2].VAL[1].R = pwmperiod / 2;
    pwmp->flexpwmp->SUB[3].INIT.R = ~(pwmperiod / 2) + 1U;
    pwmp->flexpwmp->SUB[3].VAL[0].R = 0;
    pwmp->flexpwmp->SUB[3].VAL[1].R = pwmperiod / 2;

    switch (pwmp->config->mode & PWM_ALIGN_MASK) {
    case PWM_ALIGN_EDGE:
      /* Setting active front of PWM channels of submodules 1-3.*/
	  pwmp->flexpwmp->SUB[1].VAL[2].R = ~(pwmperiod / 2) + 1U;
      pwmp->flexpwmp->SUB[1].VAL[4].R = ~(pwmperiod / 2) + 1U;
	  pwmp->flexpwmp->SUB[2].VAL[2].R = ~(pwmperiod / 2) + 1U;
      pwmp->flexpwmp->SUB[2].VAL[4].R = ~(pwmperiod / 2) + 1U;
	  pwmp->flexpwmp->SUB[3].VAL[2].R = ~(pwmperiod / 2) + 1U;
      pwmp->flexpwmp->SUB[3].VAL[4].R = ~(pwmperiod / 2) + 1U;
      break;
    default:
      ;
    }
    pwmp->flexpwmp->MCTRL.B.LDOK |= 0xE;
#endif
  }
#endif
#if (SPC5_PWM_USE_SMOD5 && !(SPC5_PWM1_USE_SYNC_SMOD))
  if (&PWMD6 == pwmp) {
    pwmp->flexpwmp->MCTRL.B.CLDOK |= 2U;

    /* Setting PWM period of submodule 1.*/
    pwmp->flexpwmp->SUB[1].INIT.R = ~(pwmperiod / 2) + 1U;
    pwmp->flexpwmp->SUB[1].VAL[0].R = 0;
    pwmp->flexpwmp->SUB[1].VAL[1].R = pwmperiod / 2;

    switch (pwmp->config->mode & PWM_ALIGN_MASK) {
    case PWM_ALIGN_EDGE:
      /* Setting active front of PWM channels of submodule 1.*/
      pwmp->flexpwmp->SUB[1].VAL[2].R = ~(pwmperiod / 2) + 1U;
      pwmp->flexpwmp->SUB[1].VAL[4].R = ~(pwmperiod / 2) + 1U;
      break;
    default:
      ;
    }
    pwmp->flexpwmp->MCTRL.B.LDOK |= 2U;
  }
#endif
#if (SPC5_PWM_USE_SMOD6 && !(SPC5_PWM1_USE_SYNC_SMOD))
  if (&PWMD7 == pwmp) {
    pwmp->flexpwmp->MCTRL.B.CLDOK |= 4U;

    /* Setting PWM period of submodule 2.*/
    pwmp->flexpwmp->SUB[2].INIT.R = ~(pwmperiod / 2) + 1U;
    pwmp->flexpwmp->SUB[2].VAL[0].R = 0;
    pwmp->flexpwmp->SUB[2].VAL[1].R = pwmperiod / 2;

    switch (pwmp->config->mode & PWM_ALIGN_MASK) {
    case PWM_ALIGN_EDGE:
      /* Setting active front of PWM channels of submodule 2.*/
      pwmp->flexpwmp->SUB[2].VAL[2].R = ~(pwmperiod / 2) + 1U;
      pwmp->flexpwmp->SUB[2].VAL[4].R = ~(pwmperiod / 2) + 1U;
      break;
    default:
      ;
    }
    pwmp->flexpwmp->MCTRL.B.LDOK |= 4U;
  }
#endif
#if (SPC5_PWM_USE_SMOD7 && !(SPC5_PWM1_USE_SYNC_SMOD))
  if (&PWMD8 == pwmp) {
    pwmp->flexpwmp->MCTRL.B.CLDOK |= 8U;

    /* Setting PWM period of submodule 3.*/
    pwmp->flexpwmp->SUB[3].INIT.R = ~(pwmperiod / 2) + 1U;
    pwmp->flexpwmp->SUB[3].VAL[0].R = 0;
    pwmp->flexpwmp->SUB[3].VAL[1].R = pwmperiod / 2;

    switch (pwmp->config->mode & PWM_ALIGN_MASK) {
    case PWM_ALIGN_EDGE:
      /* Setting active front of PWM channels of submodule 3.*/
      pwmp->flexpwmp->SUB[3].VAL[2].R = ~(pwmperiod / 2) + 1U;
      pwmp->flexpwmp->SUB[3].VAL[4].R = ~(pwmperiod / 2) + 1U;
      break;
    default:
      ;
    }
    pwmp->flexpwmp->MCTRL.B.LDOK |= 8U;
  }
#endif
}

#endif /* HAL_USE_PWM */

/** @} */
