electrosense/hardware/electrosense-converter-firmware/ChibiOS/os/hal/ports/AVR/hal_usb_lld.h

/*
    Copyright (C) 2015 Robert Lippert

    Licensed under the Apache License, Version 2.0 (the "License");
    you may not use this file except in compliance with the License.
    You may obtain a copy of the License at

        http://www.apache.org/licenses/LICENSE-2.0

    Unless required by applicable law or agreed to in writing, software
    distributed under the License is distributed on an "AS IS" BASIS,
    WITHOUT WARRANTIES OR CONDITIONS OF ANY KIND, either express or implied.
    See the License for the specific language governing permissions and
    limitations under the License.
*/

/**
 * @file    hal_usb_lld.h
 * @brief   AVR USB subsystem low level driver header.
 *
 * @addtogroup USB
 * @{
 */

#ifndef HAL_USB_LLD_H
#define HAL_USB_LLD_H

#if (HAL_USE_USB == TRUE) || defined(__DOXYGEN__)

#include "hal_usb.h"

/*===========================================================================*/
/* Driver constants.                                                         */
/*===========================================================================*/

/**
 * @brief   Maximum endpoint address.
 */
#define USB_MAX_ENDPOINTS                   7

/**
 * @brief   Status stage handling method.
 */
#define USB_EP0_STATUS_STAGE                USB_EP0_STATUS_STAGE_HW

/**
 * @brief   The address is changed after IN packet is received.
 */
#define USB_SET_ADDRESS_MODE                USB_LATE_SET_ADDRESS

/**
 * @brief   Method for set address acknowledge.
 */
#define USB_SET_ADDRESS_ACK_HANDLING        USB_SET_ADDRESS_ACK_SW

/*===========================================================================*/
/* Driver pre-compile time settings.                                         */
/*===========================================================================*/

/**
 * @name    AVR configuration options
 * @{
 */
/**
 * @brief   USB driver enable switch.
 * @details If set to @p TRUE the support for USB1 is included.
 * @note    The default is @p FALSE.
 */
#if !defined(AVR_USB_USE_USB1) || defined(__DOXYGEN__)
#define AVR_USB_USE_USB1                  FALSE
#endif
/** @} */

/*
 * If compiler supports named address spaces
 * (see https://gcc.gnu.org/onlinedocs/gcc/Named-Address-Spaces.html)
 * then mark our TX buf pointer as able to cover flash or SRAM to allow
 * for storing/transmitting constants like USB descriptors in flash to save
 * previous RAM space.
 */
#if !defined(AVR_USB_USE_NAMED_ADDRESS_SPACES) || defined(__DOXYGEN__)
#define AVR_USB_USE_NAMED_ADDRESS_SPACES  FALSE
#endif

#if (AVR_USB_USE_NAMED_ADDRESS_SPACES == TRUE) && defined(__MEMX)
#define AVR_USB_TX_BUF_ADDRESS_SPACE volatile __memx
#else
#define AVR_USB_TX_BUF_ADDRESS_SPACE
#endif

/*===========================================================================*/
/* Derived constants and error checks.                                       */
/*===========================================================================*/

/*===========================================================================*/
/* Driver data structures and types.                                         */
/*===========================================================================*/

typedef const AVR_USB_TX_BUF_ADDRESS_SPACE uint8_t *usbbufptr_t;

/**
 * @brief   Type of an IN endpoint state structure.
 */
typedef struct {
  /**
   * @brief   Requested transmit transfer size.
   */
  size_t                        txsize;
  /**
   * @brief   Transmitted bytes so far.
   */
  size_t                        txcnt;
  /**
   * @brief   Pointer to the transmission linear buffer.
   */
  usbbufptr_t                   txbuf;
#if (USB_USE_WAIT == TRUE) || defined(__DOXYGEN__)
  /**
   * @brief   Waiting thread.
   */
  thread_reference_t            thread;
#endif
  /* End of the mandatory fields.*/
  /**
   * @brief   Number of expected bytes in the most recent transmission.
   */
  size_t                       last_tx_size;
} USBInEndpointState;

/**
 * @brief   Type of an OUT endpoint state structure.
 */
typedef struct {
  /**
   * @brief   Requested receive transfer size.
   */
  size_t                        rxsize;
  /**
   * @brief   Received bytes so far.
   */
  size_t                        rxcnt;
  /**
   * @brief   Pointer to the receive linear buffer.
   */
  uint8_t                       *rxbuf;
#if (USB_USE_WAIT == TRUE) || defined(__DOXYGEN__)
  /**
   * @brief   Waiting thread.
   */
  thread_reference_t            thread;
#endif
  /* End of the mandatory fields.*/
  uint8_t                      rxpkts;
} USBOutEndpointState;

/**
 * @brief   Type of an USB endpoint configuration structure.
 * @note    Platform specific restrictions may apply to endpoints.
 */
typedef struct {
  /**
   * @brief   Type and mode of the endpoint.
   */
  uint32_t                      ep_mode;
  /**
   * @brief   Setup packet notification callback.
   * @details This callback is invoked when a setup packet has been
   *          received.
   * @post    The application must immediately call @p usbReadPacket() in
   *          order to access the received packet.
   * @note    This field is only valid for @p USB_EP_MODE_TYPE_CTRL
   *          endpoints, it should be set to @p NULL for other endpoint
   *          types.
   */
  usbepcallback_t               setup_cb;
  /**
   * @brief   IN endpoint notification callback.
   * @details This field must be set to @p NULL if the IN endpoint is not
   *          used.
   */
  usbepcallback_t               in_cb;
  /**
   * @brief   OUT endpoint notification callback.
   * @details This field must be set to @p NULL if the OUT endpoint is not
   *          used.
   */
  usbepcallback_t               out_cb;
  /**
   * @brief   IN endpoint maximum packet size.
   * @details This field must be set to zero if the IN endpoint is not
   *          used.
   */
  uint16_t                      in_maxsize;
  /**
   * @brief   OUT endpoint maximum packet size.
   * @details This field must be set to zero if the OUT endpoint is not
   *          used.
   */
  uint16_t                      out_maxsize;
  /**
   * @brief   @p USBEndpointState associated to the IN endpoint.
   * @details This structure maintains the state of the IN endpoint.
   */
  USBInEndpointState            *in_state;
  /**
   * @brief   @p USBEndpointState associated to the OUT endpoint.
   * @details This structure maintains the state of the OUT endpoint.
   */
  USBOutEndpointState           *out_state;
  /* End of the mandatory fields.*/
} USBEndpointConfig;
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
