electrosense/hardware/(commit log)

2019-04-29 Adding Bertold code
    [flash.cfg, stm32.cfg]
2019-05-01 Clean repo
    [5GHz.PcbDoc, 5GHz.PrjPCB, 5GHz.SchDoc, CPU.SchDoc, LO.SchDoc, Mixer.SchDoc, MixerHF.SchDoc, PCB.PcbDoc]
2019-09-25 Upload converter board design
    [BOM_final.xlsx, CPU.SchDoc, LO.CSV, LO.SchDoc, Mixer.SchDoc, MixerHF.SchDoc, PCB_Project3.PrjPCB, Template2.PcbDoc]
2020-04-15 Documentation of the sensor hardware
2020-06-11 new extension board-beta
    [BOM_final.xlsx, CPU.SchDoc, LO.CSV, LO.SchDoc, Mixer.SchDoc, MixerHF.SchDoc, PCB_Project3.PrjPCB, RF_Comp.PcbLib]
2020-06-11 reduced board size, fixed polygons
    [Template2.PcbDoc]
2020-07-20 Added pdf of schematic
    [BOM_final.xlsx, LO.SchDoc, Mixer.SchDoc, MixerHF.SchDoc, PCB_Project3.PrjPCB, PCB_Project3.xls, Template2.PcbDoc]
2020-08-14 started firmware v2.0
    [flash.cfg, stm32.cfg]
2020-09-24 fixing image rejection filter
    [BOM_final.xlsx, CPU.SchDoc, LO.SchDoc, Mixer.SchDoc, PCB_Project3.PrjPCB, PCB_Project3.xls, Template2.PcbDoc, Toplevel.SchDoc]
2020-09-25 fixing design
    [CPU.SchDoc, LO.SchDoc, Mixer.SchDoc, RF_Comp.PcbLib, Template2.PcbDoc]
2020-09-25 fixed BOM
    [LO.SchDoc, Mixer.SchDoc, MixerHF.SchDoc, RF_LIB.SchLib, Template2.PcbDoc]
2021-01-04 Added TODOs to fix for new board
    [system.c, system.h]
2021-01-04 schematic pdf
    [BOM_final.xlsx, Bill of Materials.xlsx, CPU.SchDoc, LO.SchDoc, Mixer.SchDoc, PCB_Project3.PrjPCB, Template2.PcbDoc, edited_electrosense Bill of Materials(946).xlsx]
2021-01-18 layout v2 updated
    [FM Electrosense Wideband Converter v2.0.PcbDoc, PCB_Project3.PrjPCB, Template2.PcbDoc]
2021-03-08 Transition form I2C expander to GPIOs in progress
    [PCB_Project3.PrjPCB]
2021-03-29 Fixed IOs in board file and system files
    [board.h, converter.h, converterSHF.c, system.c, system.h]
2021-07-08 fixed schematic V2
    [LO.SchDoc]
2021-07-22 minor change to layout
    [FM Electrosense Wideband Converter v2.0.PcbDoc, Mixer.SchDoc, PCB_Project3.PrjPCB]
2021-09-08 fix mixer circuit
    [FM Electrosense Wideband Converter v2.0.PcbDoc, Mixer.SchDoc, PCB_Project3.PrjPCB, Template2.PcbDoc]
2021-09-13 cap fix
    [Template2.PcbDoc]
2021-09-20 final layout fix
    [Bill of Materials.xlsx, FM Electrosense Wideband Converter v2.0.PcbDoc, Template2.PcbDoc, edited_electrosense Bill of Materials(946).xlsx]
2021-09-22 final layout update
    [esense.xlsx, layout.PcbDoc]
2021-09-29 changed TCXO
    [LO.SchDoc, PCB_Project3.PrjPCB, RF_Comp.PcbLib, RF_LIB.SchLib, Schlib1.SchLib, layout.PcbDoc]
2021-10-01 generated production output
    [CPU.SchDoc]
2021-10-01 changed prototype picture in firmware v2
2021-10-01 changed prototype picture
